jphacks/tka_2601/firmware/xiao/README.md

# MONBAN ファームウェア（XIAO ESP32S3）



E84 と M5Stack に分かれていた機能を、Seeed XIAO ESP32S3（無印）1 枚で動かすファームウェアです。追加基板（MAX98357A アンプ、LMD3526 PDM マイク）を前提にしています。基板の設計データはまだこのブランチにないので、ピン配置は下の表を見てください。

**実機ではまだ一度も動かしていません。** 確かめたことと確かめていないことは「[確認の状況](#確認の状況)」に書きました。

## 実機なしで試す

XIAO がなくても、次のコマンドで試せます。リポジトリのどこからでも `bash firmware/xiao/run.sh ...` で実行できます。

| コマンド | 確かめること | 必要なもの | 時間の目安 |
|---|---|---|---|
| `bash run.sh test` | 各部のホストテストと Web UI のテスト | clang、Python 3、Node.js | 1 分 |
| `bash run.sh e2e` | 本物の `/api/relay` のコードと、ファームウェアの通話処理をつないだ会話 | 上に加えて uv | 初回は依存の取得が要る |
| `bash run.sh browser` | 本物の Chromium で Web UI を開き、チャイム登録から通話まで実際にクリックして通す | e2e と同じ。初回は Chromium の取得（約 100 MB）が要る | 2 分 |
| `bash run.sh qemu` | ESP32-S3 用のバイナリを QEMU で起動し、シリアルで操作 | arduino-cli、Python 3 | 初回は ESP32 コアの取得（数 GB）が要る |
| `bash run.sh bench` | ブラウザで Web UI を操作する。通話まで動く | e2e と同じ | 起動まで数十秒 |
| `bash run.sh qemu ui` | ブラウザで Web UI を操作する。相手は QEMU 上の ESP32-S3 用バイナリ | qemu と同じ | 起動まで 1 分ほど |

Web UI を試す 2 つの違いは次のとおりです。`bench` は Mac 向けにコンパイルしたファームウェアで、音声は模擬なので通話まで進みます。`qemu ui` は実機用のバイナリそのものですが、QEMU に Wi-Fi と音声がないので、サーボの調整や保存までしか動きません。QEMU 自体に Web UI はなく、どちらも `http://127.0.0.1` の同じ画面を使います（`bench` は 8767 番、`qemu ui` は 8768 番）。

QEMU の本体は初回に公式リリースから `.host-build/` へ取得し、SHA-256 を照合します。対応するのは macOS と Linux です。Windows は WSL で動かしてください。

GitHub では、`firmware/xiao` に触れる PR ごとに `test`、`e2e`、`browser`、ビルド、`qemu` が自動で動きます。手で動かすときは Actions の「XIAO firmware」から Run workflow を押します。

## 機能

| 機能 | 内容 | 移植元 |
|---|---|---|
| チャイムの登録と検知 | ログメル特徴と DTW。環境音 5 秒、3 回の登録、別の 1 回の確認 | `firmware/psoc6` |
| 登録の保存 | 2 MiB の専用パーティションに 2 つ写しと CRC で保存 | `firmware/psoc6` |
| 録音の保存と送信 | HTTPS で WAV を送り、同じイベント ID の ACK を待つ。送信先を設定したときだけ動く | `firmware/psoc6` |
| 会話 | `/api/relay` と WSS で接続。16 kHz、16 bit、モノラルの PCM を 20 ms（640 B）ごとに送受信 | `PSOC_Edge_E84` |
| 再生 | I2S で再生し、DMA が空になってから完了を報告 | `M5Stack_Basic_E84_Link` |
| サーボ | 押して戻す動作、角度と時間の調整、USB からのテスト | `M5Stack_Basic_E84_Link` |
| 確認と調整の Web UI | Mac の `calibration_ui/` が USB シリアルで本体とやり取りする | `M5Stack_Basic_E84_Link` を作り直した |

E84 と M5 の間の UDP 通知と TCP 中継（DVS1）は削除しました。通話の処理が、サーボとスピーカーを直接動かします。

初期設定では物理プッシャー1が通話開始、2が終話です。アプリの「設定 → プッシャー設定」で、通話用に1個を共有するか、2個へ別々に割り当てるかを選べます。1個では物理1・2のどちらも選べ、2個では開始・終話の担当を入れ替えられます。接続数の自動検出は行いません。

物理3は解錠用のUSBテスト・角度調整として保持し、通話からは動かしません。中継サーバーに解錠の指示がなく、`docs/spec.md` 5.6 が「鍵やドアを開ける約束をしない」と決めているためです。

## ピン配置

`board_pins.h` に定義しています。

| XIAO | GPIO | つなぐ先 |
|---|---|---|
| D0 | 1 | アンプ DIN |
| D1 | 2 | アンプ LRCLK |
| D2 | 3 | アンプ BCLK |
| D3 | 4 | マイク DATA |
| D4 | 5 | マイク CLK |
| D5 | 6 | アンプ SD_MODE（Low で停止、駆動しないと (L+R)/2 のモノラル） |
| D8 | 7 | サーボ 1（通話） |
| D9 | 8 | サーボ 2（終了） |
| D10 | 9 | サーボ 3（解錠） |

## ビルドと書き込み

`arduino-cli` と esp32 コア 3.3.8 を使います。`arduino-cli` は PATH にあるものか Arduino IDE に入っているものを使い、コアがなければ初回に入れます。パーティションは `partitions.csv` のとおりで、PSRAM は OPI にしています。

```bash
bash run.sh build
```

```bash
bash run.sh upload /dev/cu.usbmodem1101
```

書き込みは XIAO 自身の USB-C から行います。追加基板の USB-C は電源専用で、書き込むときは抜いておきます。

## 設定

設定を変えたら、ビルドと書き込みをやり直します。作られるヘッダーは Git の対象外です。

Wi-Fi の設定です。iPhone のテザリングでは `--hotspot` を付けます。

```bash
python3 configure_wifi.py
```

サーバーの設定です。`.env.example` を `.env` にコピーして `DOOR_API_KEY`、`DOOR_RELAY_MODE`、`DOOR_DEVICE_KEY` を入れてから実行します。

```bash
python3 configure_api.py
```

録音の送信先は任意です。設定しない間は、録音をフラッシュに保存しません。`docs/spec.md` 5.2 と 10 章で扱いが未定のため、既定で切っています。

```bash
python3 configure_upload.py --ca /path/to/receiver-root-ca.pem
```

## 最初に動かす手順

### アプリからのプッシャー設定

アプリに保存した設定は、XIAOが待機中に取得し、本体への保存と読み戻しを確認してから反映結果を返します。通話中は割り当てを切り替えません。設定を保存しただけでは反映済みにならないため、本体への反映完了を確認してから取り付けを変更します。

本体の`.env`に`SUPABASE_URL`・`SUPABASE_PUBLISHABLE_KEY`と登録済みの`DOOR_DEVICE_KEY`を設定し、接続先の信頼するCAを指定します。

```sh
python3 configure_api.py
python3 configure_device.py --ca /path/to/trusted-root-ca.pem
bash run.sh build
```

生成した`device_config.h`はGit対象外です。設定APIの追加契約、XIAO、アプリの順に導入します。[実装・検証記録](../../docs/verification/pusher-assignment.md)に、エミュレーターで確認した範囲と未確認の実機動作を記載しています。

共有ボタンの押下中に中断・電源断が起きた場合や、共有する出力を単体テスト・プレビューした後は、親機を手動で終話してからUSB調整画面で待機状態を確認します。`@confirm`も同じ確認操作で、ボタンを押しません。再起動や割り当て変更だけでは要確認状態を解除しません。

### アプリからの動作モードと死活通信

アプリで選んだ動作モード（通常・おまかせ・外出・停止）は、待機中に15秒ごとに`GET /functions/v1/device/mode-settings`で取得します。ネットワークタスクが取得するため、チャイムの検知と通話は待たされません。通話中は取得しません。

- 取得した値は、通話中継への`mode`に使います。ビルド時の`DOOR_RELAY_MODE`は、一度も取得できていないときの初期値だけです。
- 最後に取得できた値をNVSに保存し、再起動後と通信できない間はその値で動きます。保存できなかったときも取得した値を使い、次の取得で保存を再試行します。
- 未対応の値、型や契約版が違う応答、HTTPエラー、未ペアの応答は、最後の正常値を変えません。不明な値を停止として扱うことはありません。
- 停止モードでは、チャイム検知と手動の通話要求を通話開始の前に捨てます。待たせて後から再生することはありません。通話中に切り替わっても、始まっている通話は止めません。通信確認用のAPI試験とスピーカー試験は停止モードでも使えます。
- `PUT /functions/v1/device/heartbeat`は、通信できる間60秒ごとに送ります。失敗したときは10秒から始めて60秒まで間隔を延ばして再試行し、成功した時刻だけを送信済みとして扱います。アプリの接続切れ通知は15分間heartbeatが途絶えたときです。

- `PUT /functions/v1/device/mode-status`（本文`{"mode":"normal"}`）で、本体が実際に動かしているモードをクラウドの`devices.applied_mode`へ報告します。アプリが保存した`devices.mode`とは別の値です。報告するのは、このブート中に`mode-settings`の取得が成功し、そのモードで動いているときだけです。NVSに保存された値やビルド時の`DOOR_RELAY_MODE`で動いている間は、取得が成功するまで報告しません（アプリの設定として動いているとは言えないため）。取得に成功した最初の1回は、モードが同じでも送ります。以後はモードが最後に報告に成功した値と変わったときだけ送ります。
  - 保存に失敗したモードも、実際に動いているので報告します。200以外と通信失敗は未送信として扱い、10秒から60秒までの上限つきの間隔で再試行します。新しいモードに変わったときは、古い失敗の間隔を引き継がず10秒から数え直します。取得・heartbeat・チャイムは報告の失敗に待たされません。
  - 未ペアの応答を受けたら報告済みの記録を捨て、ペアリング後に取得が成功した時点で改めて1回送ります。
  - `applied_mode_at`はクラウドが報告を受けた時刻で、本体の生存を示しません。本体との最後の通信は`last_heartbeat_at`です。
  - 実装は`device_mode_sync.c`、試験は`tests/device_mode_report_test.c`です。

同じ`device_config.h`の設定（`configure_device.py`）を使います。未設定の本体は、取得も送信もしません。

### 停止モードで応答しなかった来客の記録

停止モードでチャイム検知か手動の通話要求を捨てたとき、その来客を`PUT /functions/v1/device/visits/<uuid>`で記録します（`docs/spec.md` 5.1）。送る本文は`{"status":"missed","end_reason":"mode_off","mode":"off","chimed_at":"<UTC ISO 8601>"}`だけです。`chimed_at`は捨てた時点のNTP時刻です。`visit_report.c`が実装します。

- 時計が未同期（2024-01-01より前）のときは記録せず、ログに残します。偽の時刻は送りません。
- UUIDは本体が作ります。同じ来客の再送はサーバー側で1件のままです。
- 音声タスクは、メモリ上の4件のキューに積むだけで、通信を待ちません。送信はネットワークタスクが1回に1リクエストずつ、通話中以外に行います。
- キューが満杯のときは、新しい来客を捨てます（古い順に送り終えます）。20秒以内の続けてのチャイムは、通話後の待機と同じく1人の来客として数えます。
- 失敗は10秒から始めて60秒まで間隔を延ばし、1件につき最大6回送ります。それでも届かない件は捨てます。400番台（408、429を除く）は同じ本文では成功しないため、すぐ捨てます。
- キューは再起動で消えます。電源断をまたいで残す永続キューは、Issue #44の範囲で、未実装です。
- チャイム検知は、Wi-Fiと時計が使えない間は始まらないため、その間の停止モードのチャイムは記録されません。
- アプリの履歴一覧は`missed`を表示しません。この記録で届くのは、来客時のプッシュ通知までです。

ホストテスト（`bash run.sh test`の`visit_report`）とDBテストで確認した範囲です。実機のXIAOと実際のSupabaseでの動作は未確認です。

### 通話の順序と復旧

v2ではAPIのWSS接続と`ready`を確認してから通話ボタンを押し、ボタンが戻った後にエージェントを開始します。APIに接続できない場合は、ボタンを押さずにチャイム検知を再開します。従来のv1は通話ボタンを押した後に接続します。

通話ボタンの操作開始から50秒で通話を打ち切り、操作後20秒は新しい通話を受け付けません。終話を確認できなかった場合、開始と終了に別々のボタンを使う構成では、10秒、20秒、以後30秒の間隔で終了ボタンを再試行します。終了ボタンの操作が済み、録音の再開だけに失敗した場合は、サーボを動かさずに再開を試みます。

開始と終了に同じボタンを使う構成では、再押下による通話開始を避けるため自動で押し直しません。親機を手動で終話してからUSB調整画面、または`@confirm`で待機状態を確認します。プッシャー設定の適用待ちやサーボの要確認状態も、自動復旧では解除しません。

本体が確認するのはサーボの動作完了です。実際に親機が終話することや、押下中のサーバー接続が保たれることは、実機で未確認です。

### USB調整画面

`python3 calibration_ui/server.py --serial-port /dev/cu.usbmodem1101` を実行し、`http://127.0.0.1:8767` を開きます。あとは画面の順に進めます。

どの画面でも右側に 3D モデルが出ます。上のバーでインターホンの機種と外装を選びます。モデルは本体のログと設定値で動くので、サーボの押下、呼び出し、再生、聞き取りがそのまま見えます。その下に、部品がキーや画面、充電台に当たらないかを計算して出します。機種の外形は公開値で、キー位置は推定です。実測したら「寸法とキー位置を変える」に入れてください。機種は `calibration_ui/scene/monban_scene.js` の `INTERCOMS` に足すと増やせます。`rough` の付いた機種は、`coverage.md` の外形とキーの説明だけから配置を仮置きしています。縦に串を通す Windea-R と Windea D、キーの情報がない機種はまだ入っていません。外装は同じファイルの `DESIGNS` です。

| 画面 | できること |
|---|---|
| 仮想ボード | `bench` と `qemu ui` で出る。チャイムや違う音を鳴らし、通話を通しで試す。実機の接続先では出ない |
| テスト | `run.sh` の `test`、`e2e`、`build`、`qemu` を実行し、結果とログを見る |
| 動作確認 | 通信、マイク、スピーカー、サーボ、チャイム、通話を順に確かめる。音と動きは「聞こえた」「動いた」で答える |
| サーボ | 通話、終了、解錠の角度と時間を合わせて本体に保存する。ホーンを外した状態で始める |
| 音 | マイクの音量を見ながら話し始めの音量を決める。スピーカーの音量とチャイムの判定幅を変える |
| チャイム | 案内に従って登録する。保存領域が未初期化なら、そのときだけ初期化のボタンが出る |
| テスト通話 | 通話を始める、止める。進行状況、会話、本体のログを見る |

実機がなくても、この画面を次のコマンドで動かせます。本物のファームウェアのコードと中継のコードを Mac 上で動かします。マイク、スピーカー、PWM は模擬で、音声 AI は決まった応答に置き換えています。チャイムは画面のボタンで鳴らします。

```bash
bash run.sh bench
```

## シリアルのコマンド

1 行に 1 つ送ります。

| 入力 | 動作 |
|---|---|
| `h` | 一覧 |
| `s` | 状態 |
| `c` / `q` | 通話を始める / 止める |
| `e` / `x` | チャイム登録を始める / 登録とサーボのテストを止める |
| `r` | 5 秒録音して送信待ちにする（送信先の設定が必要） |
| `1` `2` `3` | サーボのテスト（通話、終了、解錠） |
| `t` | スピーカーで 1 kHz を 1 秒鳴らす |
| `l` | 3 秒録音してそのまま再生する。保存はしない |
| `m` | マイクの音量と検知の状態 |
| `n` `a` `w` `u` | Wi-Fi、サーバーの HTTPS、音声の WSS、USB の確認 |
| `@get` `@begin` `@set` `@angles` `@time` `@test` `@stop` `@mirror e` `@save` `@cancel` | サーボの調整。M5 と同じ形で、`u`（解錠）を足した |
| `@tune get`、`@tune volume 0..100`、`@tune gate 30..32767`、`@tune margin 50..200` | 音量、話し始めの音量、チャイムの判定幅。すぐに NVS へ保存する |
| `FORMAT_AUDIO_STORAGE` | 保存領域を消去して初期化する。Web UI からは未初期化のときだけ送れる |

## テスト

```bash
bash run.sh test
```

移植元のホストテストに相当するものです。C と C++ は AddressSanitizer と UndefinedBehaviorSanitizer を付けて動かします。

```bash
bash run.sh e2e
```

`backend/voice-agent` の本物の `/api/relay` v2 のコードに、このファームウェアの通話処理をそのままつなぐテストです。通常の会話、チャイムから始まる通話、途中で止めた通話、サーバーに届かないとき、API キーを拒否されたときを確かめます。置き換えているのは次の部分だけです。

- 音声認識、応答生成、音声合成
- TLS（平文の TCP でつなぐ）
- マイク、スピーカー、PWM、NVS、フラッシュ

```bash
bash run.sh qemu
```

ESP32-S3 用にビルドしたバイナリを、Espressif の QEMU で起動してシリアルで操作するテストです。実機向けのビルドとの違いは、QEMU に合わせた次の 3 点だけです。

- 出力先が USB CDC ではなく UART
- フラッシュが QIO ではなく DIO
- USB 専用のタイムアウト設定 1 行を除く

QEMU には Wi-Fi と I2S のデータがないため、ネットワークと音はこのテストでは確かめられません。

## 確認の状況

### 確かめたこと

- `esp32:esp32:XIAO_ESP32S3` 向けのビルド（プログラム 32%、静的 RAM 61%）
- `bash run.sh test`：すべて成功。動作モードの追従（厳密な解析、最後の正常値の保持と再起動後の復元、停止モードでの通話の遮断、取得とheartbeatの間隔、適用モードの報告の条件・再試行・重複なし）は、模擬のHTTPとNVSで確かめた
- `bash run.sh e2e`：5 件すべて成功（動作モードの追加後も実施）
- `bash run.sh qemu`：すべて成功。確かめたのは次の項目です。
  - 実バイナリの起動、PSRAM、パーティション、全タスクの起動
  - PDM、I2S、LEDC の各ドライバーが設定を受け付けること
  - 3 つのサーボの動作と、シリアルのコマンド
  - NVS への保存と 2 MiB の領域の初期化、電源を入れ直した後の復元
  - ネットワークやマイクがないときに固まらず失敗を報告すること
- `bash run.sh browser`：Chromium（Playwright）で、全画面の表示と 3D の描画、機種と外装の切り替え、実測値の入力、接続とスピーカーとサーボの確認、チャイム登録、チャイムからの通話、通話の停止、テストの実行と停止、狭い画面幅を確かめ、コンソールにエラーがないことを確認
- `bash run.sh bench` とブラウザで、Web UI の主な操作（機種と外装の切り替え、まとめて確認、サーボのテスト、チャイム登録、チャイムからの通話とその間の 3D の動き、違う音の判定、テストの実行）

### 実機で確かめていないこと

下の項目は、どれも動作を確認していません。

| 項目 | 確かめること |
|---|---|
| 起動 | QIO フラッシュと USB シリアルでの起動（QEMU は DIO と UART で確認） |
| Wi-Fi と時刻 | 接続、再接続、NTP の同期、テザリングでの接続 |
| TLS と WSS | 実サーバーとの証明書の検証、有効期限の確認、接続中のメモリの余裕 |
| マイク | LMD3526 から正しい音が取れるか。特に左チャンネルの指定と 2.048 MHz のクロック |
| アンプ | MAX98357A が鳴るか、SD_MODE の切り替え、切り替え時の雑音、音量 70% が適切か |
| サーボ | FS0307 が 1000〜2000 µs で必要な角度に動くか（M5 で使った SG90 の値のまま）。14 bit の PWM の精度。押す角度の既定 30 でキーが押せるか。30 は 167 µs ぶんで、実際の回転角は測っていない。サーボ画面のラックの mm は、指定どおりの角度で回った場合の計算 |
| サーボの向き | 既定では通話と終了のパルスが逆向きに動く。機構に対して正しいか |
| 電源 | サーボが動くときと大きな音のときに電圧が下がらないか |
| 同時動作 | Wi-Fi、TLS、マイク、再生を同時に動かしたときに音が途切れないか |
| フラッシュ | 消去中にマイクの取り込みが途切れないか（1 セクターごとに消去している） |
| チャイム | 実際の呼び出し音での取り逃しと誤検知。しきい値は初期値のまま |
| 話し始めの判定 | `VOICE_RMS_GATE` の 600 は E84 のマイクの値で、このマイクでは測っていない |
| 回り込み | スピーカーとマイクが同じ外装に入ったときの影響 |
| 通話全体 | 実際のインターホンと実サーバーでの連続した会話 |
| 動作モードとheartbeat | 実サーバーでのモード取得、停止モードで実際のチャイムに応答しないこと、再起動後と通信断のときに最後の正常値で動くこと、heartbeatがアプリの接続切れ通知と一致すること。適用モードの報告も、ホストテストの模擬サーバーだけで、実サーバーの`devices.applied_mode`への反映は未確認。ホストテストは模擬のHTTPとNVSで確かめただけ |
| 録音の送信 | 実際の受信サーバーへの送信 |
| v1 の中継 | `VOICE_RELAY_PROTOCOL=1` は C のテストだけで、LiveKit とはつないでいない |

## 移植元から変えたこと

- サーボの PWM は 16 bit から 14 bit にしました。ESP32-S3 の LEDC は 14 bit までです。
- 再生後に録音を始めるまでの待ちは 250 ms から 500 ms にしました。`docs/spec.md` 5.1 の値です。
- mbedTLS のこのビルドは証明書の有効期限を見ないため、接続後に NTP の時刻と照合しています。
- 音量の既定は 70% です。5 V のアンプはフルスケールで 1 W のスピーカーの定格を超えるおそれがあるためです。
- チャイムを検知したら、録音の残りを待たずに通話を始めます。録音の保存は通話が終わってから行います。フラッシュの処理で通話の音が途切れないようにするためです。

## 未実装

E84 と M5 にもなく、`docs/spec.md` だけにある機能は移していません。

- 定型音声 U01、X01（5.7）
- 本体から Supabase の Edge Function への送信（5.5）
- 通話後 20 秒のチャイム検知の停止（5.1）
- 停止モードで応答しなかった来客の記録は、メモリ上のキューまで実装済みです（上の節）。再起動をまたぐ永続化は未実装です（Issue #44）
- 適用モードの報告（`PUT /mode-status`）は、実機と実サーバーではまだ確かめていない（上の節）。取得した時刻の報告は未実装で、通信の生存は heartbeat だけが伝える

押す時間の上限は M5 と同じ 2000 ms です。`docs/spec.md` 4.4 は 500 ms を上限としているので、VS-MGE20 で使うときは 500 ms 以下に合わせてください。
