jphacks/tka_2601/PSOC_Edge_E84/docs/voice-stream.md

# E84・M5の音声会話

## 実装した流れ

チャイム検知、またはE84のUARTで `c` → APIへWSS接続して `ready` を確認 → M5の接続確認 → 設定した時間だけ待つ → 通話ボタンを1回押す → 待機位置へ戻してPWM停止 → agent開始 → 挨拶 → 来訪者の音声 → ASR/LLM/TTS → M5再生 → 次の録音、を繰り返します。会話終了時は最後の音声の再生後に終了ボタン用サーボを動かします。`q` は録音・再生を止めて通話終了を要求します。APIに届かないときは、M5へ接続せず通話ボタンも押しません。この先行接続はv2の順序です。v1は従来どおりボタン操作の後にAPIへ接続します。

E84がWi-Fi/API認証と会話状態を管理します。CM55はPDM取得・チャイム照合・発話区切り、CM33はWSSとM5へのTCP転送を担当します。クラウドへは既存の `/api/relay` にJSON制御と生PCMを送り、M5へは従来のDVS1を送ります。サーバーのv2経路は既存DoorAgentを同じLiveKit Agents SDKのAgentSession内で動かします。音声認識は発話確定後に既存STTクライアントで実行し、応答生成・TTS・住人ルールを再利用します。ブラウザーと旧relayのLiveKitルーム経路は維持します。

音声は16kHz/16bit/mono。20ms（640バイト）単位で送信し、発声後の無音1.2秒または30秒で区切ります。30秒には200msの先行バッファと末尾無音も含みます。無音だけなら音声フレームを送信せず待ちます。最初の発話待ちは60秒です。サーバーの通話上限は既存の `DOOR_RELAY_MAX_SESSION_SECONDS`（既定120秒）に従います。端末にも切断時の上限がありますが、サーバーの期限を延長するものではありません。

発声判定はRMSを使います。`source/voice_settings.h` の `VOICE_RMS_GATE`（既定600）以上が60ms続くと開始し、その半分未満の音量が1.2秒続くと終了します。学習済みVADではないため、設置場所の雑音・マイク音量で調整してください。録音と返答の同時進行・割り込み発話には対応しません。

CM55→CM33は64フレーム、1.28秒分の共有リングです。共有領域の使用量は約233KBで256KiB以内です。30秒分全体をE84に保持しません。サーバーはASRのため1発話を最大960KBまで保持します。応答待ち・再生中のマイクサンプルは捨て、次の録音に混ぜません。

## サーバーへ反映

既定は `VOICE_RELAY_PROTOCOL=2` です。2026-10-18に稼働中サーバーから `ready` / `protocol_version:2` を確認し、非個人の合成音声で発話送信→ASR→返答PCM→次の聞き取りまで成功しました。E84の無音判定で発話を確定し、`input_end` のフレーム数・サンプル数をサーバーが検証した後にASRへ渡します。サーバーの別のVADによる再判定はありません。M5の実再生完了後に `playback_done` を送り、明示的な `listen` が届いてから次の録音を始めます。

稼働中サーバーのv2は現時点では `transcript` を端末へ転送しません。Web UIの会話テキストを表示するには、[サーバー用の追加パッチ](../../deliverables/relay-v2-log-update-20261018/README.md) をAPIプロセスへ適用します。このMacからはサーバーへ未適用です。音声の送受信とは別の追加修正です。

旧サーバーを使う場合は `VOICE_RELAY_PROTOCOL=1` に戻します。v2はバージョンなしreadyを拒否し、暗黙にv1へ切り替えません。`POST /api/connect` はブラウザーのLiveKit用で、E84の接続先には使いません。OpenAPIにはWebSocketは表示されません。

旧v1経路では `agent_state: listening` の後も低い非ゼロPCMが続くことを確認しています。v1接続ではこの状態通知から500msの末尾音声を受けた後にM5へ `OUTPUT_END` を送り、それ以後の待機PCMを捨てます。単なるPCMの途切れだけでは終了しません。M5から実再生完了が戻り、250msの残響待ちを終えてから次の録音を許可します。LiveKitのVADがE84の無音1.2秒より先に返答を始めた場合も、録音を止めて再生へ切り替え、残った入力を次の発話に混ぜません。AIの確定文字起こしに「失礼いたします」が含まれる場合、最後の再生後に終了操作を行います。手動終了はUART `q` です。 ローカルRMSが拾った音をサーバー側VADが認識しない場合に備え、入力終了後もagentが聞き取り状態のまま20秒経過するとマイクを再待機します。`thinking` や再生中には再待機せず、遅れて返答が始まった場合も直ちに録音を止めます。認識内容・agent状態・既知のエラーコードはUSB/Web UIへ表示します。

v2の通話では発話単位の制御、フレームACK、`output_end` / `listen` / `call_end` を使います。終了時は `Call ending: reason=...`、サーバー通知時は既知の `Server error code` / `Server end reason` を表示し、正常終了・時間上限・切断・音声送信失敗を区別します。サーバーの時間上限を端末側で延長することはありません。

E84の `.env` にAPI設定に加えて `DOOR_RELAY_MODE=omakase` と `DOOR_DEVICE_KEY` を設定します。デバイス鍵はSupabaseの住人設定取得・履歴保存用で、FastAPI認証の `DOOR_API_KEY` とは別です。両バージョンとも鍵が空なら、バックエンド付属シミュレーターと同様に未登録の診断用IDで通話できます。この場合、住人設定の取得と履歴保存はできません。未登録状態は本体ログに明示します。APIへのBearer認証は引き続き必須です。キーを設定した後、設定生成とビルドを行います。M5との通信は設定済みUDPポート+1（標準8769/TCP）と、同じペアリングトークンを使います。

## 書き込み

M5を先に更新します。USBポートは現在の接続に合わせて指定してください。

```sh
cd /Users/fukawanozomi/Documents/ChatGPT/jphacks/M5Stack_Basic_E84_Link
bash run.sh build
bash run.sh upload /dev/cu.usbserial-58650035241
```

続いてE84を更新します。

```sh
cd /Users/fukawanozomi/Documents/ChatGPT/jphacks/PSOC_Edge_E84
python3 configure_api.py
make -j8 build
make -j8 program
```

M5のIPが変わった場合は、既存の `python3 configure_m5.py --host <M5のIP>` で更新します。両方を同じiPhoneテザリングまたはLANへ接続してください。

## サーボのサンプル

通話用GPIO26、終了用GPIO17の2台構成です。標準の通話動作は3秒待機→押下位置を0.3秒保持→待機位置へ1秒戻してPWM停止です。角度・通話前待機・通話と終了の押下時間・復帰時間はWeb UIで保存できます。旧版の保存済み角度は引き継ぎます。通話ボタンの操作完了通知を受け取るまで、E84はagent開始のJSON（`call_started`）を送りません。v2ではWSS接続と `ready` の確認はその前に済ませ、ボタン操作中も5秒ごとのPINGで接続を保ちます。v1ではWSS接続自体をボタン操作の後に行います。実サーボ用の電源と共通GND、角度調整は[M5 README](../../M5Stack_Basic_E84_Link/README.md)を参照してください。センサーはなく、完了通知はPWM操作の完了を意味します。

未配線でもサンプルPWMコードは動作します。ボタンを人が押して連携を確認する場合は、M5の `servo_config.h` で `M5_SERVO_ENABLED 0`、`M5_SERVO_MANUAL_TEST 1` を明示します。開始はM5のA、終了はCで操作完了を通知します。

## 順に確認すること

1. E84の `t` で従来のUDP往復を確認します。
2. E84の `c` でチャイム検知を省略して通話を開始します。通話用サーボが動くので、取り付け前に角度を確認してください。
3. M5から挨拶が流れ、E84が `M5 playback complete` → `Listening` と表示することを確認します。
4. 話した後に1.2秒黙り、`Input complete` → M5の返答 → 次の `Listening` になることを確認します。
5. 長い発話を30秒で区切ること、返答再生中に録音が開始しないことを確認します。
6. `q` または会話の終了で終了ボタン用サーボが動くことを確認します。
7. 最後に実際のチャイムから開始します。通話中は再検知を抑制します。

切断・PCM欠落・バッファあふれでは不完全な発話を取り消します。M5は音声を停止し、通話押下済みなら終了ボタンを一度押します。E84がM5の終了を確認できない場合は録音を止めたままにし、M5へ自動で再接続します。再接続は10秒、20秒、30秒の間隔で行い、30秒が上限です。M5が `CALL_ENDED` を返したら、チャイム検知を再開します。待機中の本体ログは、初回と60秒ごとにだけ出ます。再接続で送るのは `HELLO` と `CANCEL` だけで、通話開始やボタン操作は行いません。M5が応答しない間は新しい通話を始めません。M5の状態が不明のままなら、インターフォンの状態を確認してM5を再起動してください。

SDKのTCP接続確立処理は同期呼び出しで、接続先が応答しない場合はSDKの接続タイムアウトまで待つことがあります。この間は録音を停止します。v2ではAPIへ接続して `ready` を確認した後に、M5の接続を確認してボタンを操作します。APIに届かなければボタンは押さず、録音を再開します。ボタン操作中にAPIとの接続が切れた場合は、M5へ終了操作を要求します。v1では従来どおりM5のボタン操作の後にAPIへ接続し、接続に失敗するとM5へ終了操作を要求します。シリアルの `q` は接続呼び出しが戻った時点で処理します。

## 検証範囲

ホストテストでは30秒・1.2秒境界、録音停止、欠落、再生完了の条件、JSON/PCMとDVS1の変換、WebSocket分割、通信切断、サーボ重複抑止を検証します。v1については待機中PCM、発話状態後の末尾音声、M5再生完了待ち、先に返答を始めるサーバーVAD、20msの無音送信も確認します。実機ではE84から実サーバーへの接続とM5での挨拶再生、ch3のマイク入力を確認済みです。位置合わせ後の実機連続通話は別途確認が必要です。

Macから実サーバーのASR・LLM・TTSだけを一往復させる診断もできます。`websocket-client` と `certifi` のあるPythonで、16kHz・16bit・monoの訪問者WAVを渡します。

```sh
python3 tools/relay_smoke_test.py visitor.wav --seconds 60
```

認証はこのE84プロジェクトの `source/api_config.h` を読み、登録住人に紐付かない診断用IDで既存 `/api/relay` へ接続します。サーボ・E84のマイク・M5のスピーカーを経由するテストではありません。空のWAV・全ゼロ音声・30秒を超える音声を拒否し、来訪者の文字起こし・AI文字起こし・返答PCMのすべてが確認できた場合だけ終了コード0になります。2026-10-18に「こんにちは。宅配便です。荷物をお届けに来ました。」から「恐れ入りますが、玄関の前に置いていただけますか。」の返答PCMまで成功しました。

最新TTSは不要な末尾音を除くため返答全体の生成を待ってから音声を流します。今回の更新はこの処理を変更しません。音声の転送・M5での再生はフレーム単位ですが、生成途中からの低遅延再生を保証するものではありません。

実機を動かさないv2の診断（送信してよい音声のみ）:

```sh
python3 tools/relay_v2_smoke_test.py diagnostic.wav --seconds 90
```

640バイトのPCM、発話終了、全フレームのACK、再生完了、次の聞き取りまでを確認します。登録住人の鍵を使わず、サーボは動かしません。実機のマイクの音質や取り付け位置は別に確認してください。

UART `v` またはWeb UIの「音声用TCPを確認」で、M5へのHELLO/READY認証とPING/PONGを診断できます。`CALL_START` / `CALL_END` / `CANCEL` は送信せず、サーボ・マイク・agentを起動しません。調整中のM5はTCP接続を拒否するので、角度を保存または取消してから実施します。`t` は別のUDP疎通診断です。

送信バッファの一時的な満杯（Secure Sockets `WOULDBLOCK`、`0x082a001a`）は切断とみなさず、最大2秒の範囲で未送信部分を再試行します。部分送信済みのバイトは再送しません。Secure Sockets 3.12.2のTCP送信はlwIPへNOCOPYで渡すため、CM33_NSのリンク時に `netconn_write_partly` を `socket_copy.c` でラップし、`NETCONN_COPY` を付けます。取得済みのSDKソースは変更せず、一時的な音声・TLS送信バッファを再利用しても未送信データが上書きされないようにしています。

異常終了でM5の停止を確認できない場合、復旧待ちフラグで新規通話と録音を抑止します。フラグはM5が停止を確認するまで解除されず、上記の自動再接続が解除を試みます。ネットワーク処理のbusyとは分離しているため、UDP/TCP/HTTPS/WSSの診断を実行できます。M5が応答しないままなら、実機を確認してM5を再起動します。音声中継は1msの受信待ちと最大4パケットのまとめ読みで、M5の応答とマイク入力を継続して処理します。
