jphacks/tka_2601/firmware/wifi-check/images/figure2.png

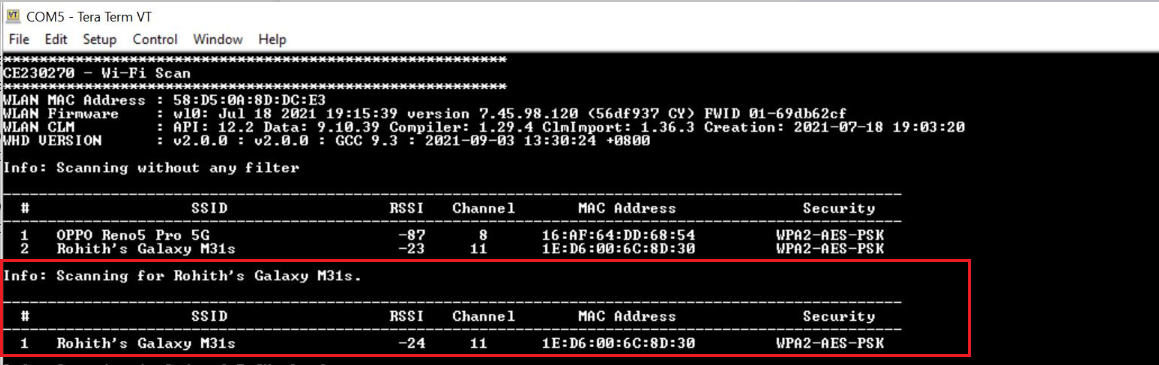
firmware/wifi-check/images/figure2.png
