jphacks/tka_2601/firmware/wifi-check/images/figure3.png

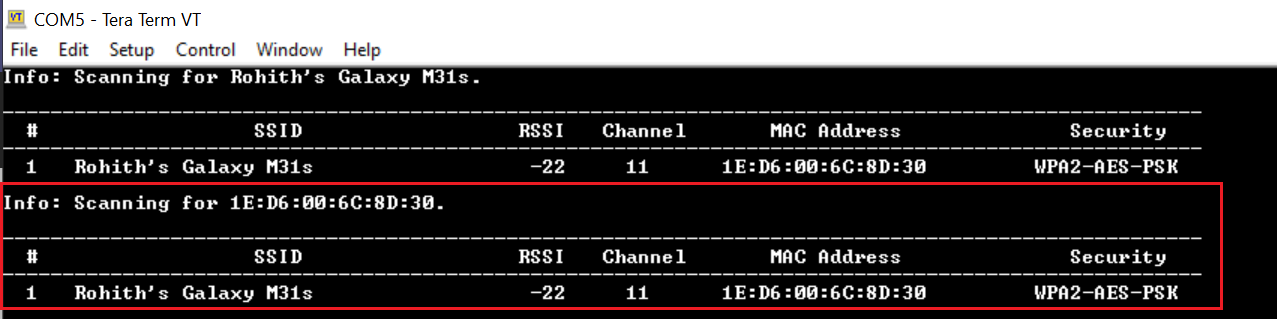
firmware/wifi-check/images/figure3.png
