jphacks/tka_2601/hardware/vsmge20_print_ready/layout.csv

plate | part | x_mm | y_mm | rotate_xy_90 | footprint_x_mm | footprint_y_mm | height_mm
2 | PRINT_01_Front_guard.stl | 5.00 | 5.00 | False | 127.00 | 84.00 | 7.60
2 | PRINT_02_Upper_bridge.stl | 5.00 | 92.00 | False | 108.00 | 20.00 | 14.50
2 | PRINT_03_Lower_bridge.stl | 5.00 | 115.00 | False | 108.00 | 20.00 | 14.50
2 | PRINT_04_Call_servo_pod_base.stl | 135.00 | 5.00 | True | 50.00 | 25.00 | 3.00
2 | PRINT_05_End_servo_pod_base.stl | 5.00 | 138.00 | False | 50.00 | 25.00 | 3.00
2 | PRINT_06_Call_pod_retainer.stl | 116.00 | 92.00 | False | 42.90 | 19.70 | 4.80
2 | PRINT_07_End_pod_retainer.stl | 116.00 | 115.00 | False | 42.90 | 19.70 | 4.80
1 | PRINT_08_Charger_cradle_frame.stl | 5.00 | 5.00 | False | 152.00 | 108.00 | 48.00
3 | PRINT_09_Call_pusher_shaft.stl | 16.40 | 5.00 | False | 7.00 | 7.00 | 1.90
2 | PRINT_10_Call_stop_collar.stl | 126.20 | 138.00 | False | 17.00 | 17.00 | 1.20
2 | PRINT_11_Call_guide_ring.stl | 146.20 | 138.00 | False | 14.00 | 14.00 | 1.60
3 | PRINT_12_End_pusher_shaft.stl | 45.20 | 5.00 | False | 5.60 | 5.60 | 1.90
2 | PRINT_13_End_stop_collar.stl | 163.00 | 5.00 | False | 10.60 | 10.60 | 1.20
3 | PRINT_14_End_guide_ring.stl | 5.00 | 5.00 | False | 8.40 | 8.40 | 1.60
3 | PRINT_15_Call_servo_horn.stl | 26.40 | 5.00 | False | 6.40 | 6.40 | 3.00
3 | PRINT_16_End_servo_horn.stl | 35.80 | 5.00 | False | 6.40 | 6.40 | 3.00
2 | PRINT_17_Call_servo_arm_HOME.stl | 58.00 | 138.00 | False | 31.10 | 20.83 | 2.00
2 | PRINT_18_End_servo_arm_HOME.stl | 92.10 | 138.00 | False | 31.10 | 20.83 | 2.00
2 | PRINT_19_Call_fork_cheek_A.stl | 161.90 | 92.00 | False | 10.00 | 3.20 | 1.00
2 | PRINT_20_Call_fork_cheek_B.stl | 161.90 | 115.00 | False | 10.00 | 3.20 | 1.00
2 | PRINT_21_End_fork_cheek_A.stl | 163.19 | 138.00 | False | 10.00 | 3.20 | 1.00
2 | PRINT_22_End_fork_cheek_B.stl | 5.00 | 166.00 | False | 10.00 | 3.20 | 1.00
3 | PRINT_23_Call_follower_pin.stl | 53.80 | 5.00 | False | 3.00 | 3.00 | 2.00
3 | PRINT_24_End_follower_pin.stl | 59.80 | 5.00 | False | 3.00 | 3.00 | 2.00
4 | TPU_01_Call_button_pad.stl | 5 | 5 | False | 6.999217987060547 | 6.998434066772461 | 0.800000011920929
4 | TPU_02_End_button_pad.stl | 16.999217987060547 | 5 | False | 5.599998474121094 | 5.596870422363281 | 0.800000011920929
