jphacks/tka_2601/hardware/vsmge20_print_ready/FRIEND_PRINT_PACKAGE/Plate_02_main_PLA_square20.3mf

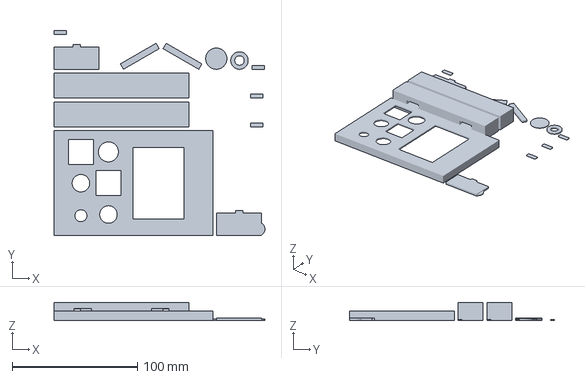
[picture p4: CAD file, 2026-10-17]
hardware/vsmge20_print_ready/FRIEND_PRINT_PACKAGE/Plate_02_main_PLA_square20.3mf
168.6 x 164.2 x 14.5 mm
