jphacks/tka_2601/hardware/vsmge20_print_ready/PLA_parts/PRINT_11_Call_guide_ring.stl

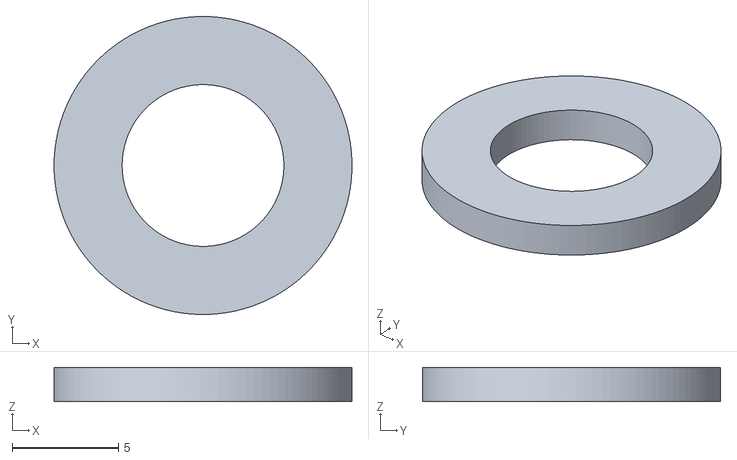
[picture p5: CAD file, 2026-10-17]
hardware/vsmge20_print_ready/PLA_parts/PRINT_11_Call_guide_ring.stl
14.0 x 14.0 x 1.60
