jphacks/tka_2601/hardware/vsmge20_print_ready/VS-MGE20_E84_M5StackBasic_A1mini_0p12_PLA.3mf

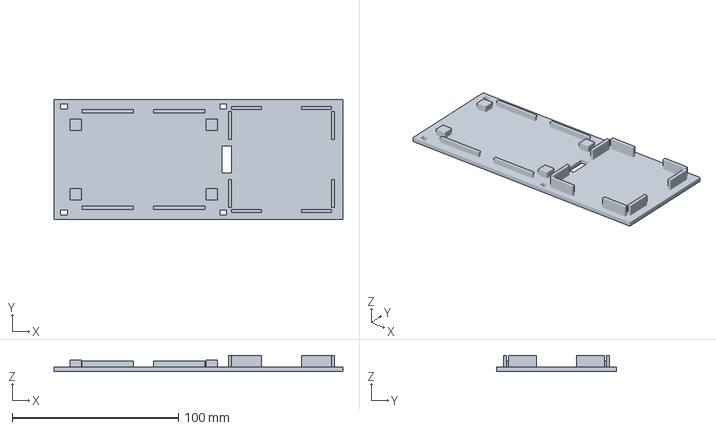
[picture p6: CAD file, 2026-10-17]
hardware/vsmge20_print_ready/VS-MGE20_E84_M5StackBasic_A1mini_0p12_PLA.3mf
174.0 x 72.0 x 9.80 mm
