jphacks/tka_2601/hardware/vsmge20_print_ready/PLA_parts/PRINT_24_End_follower_pin.stl

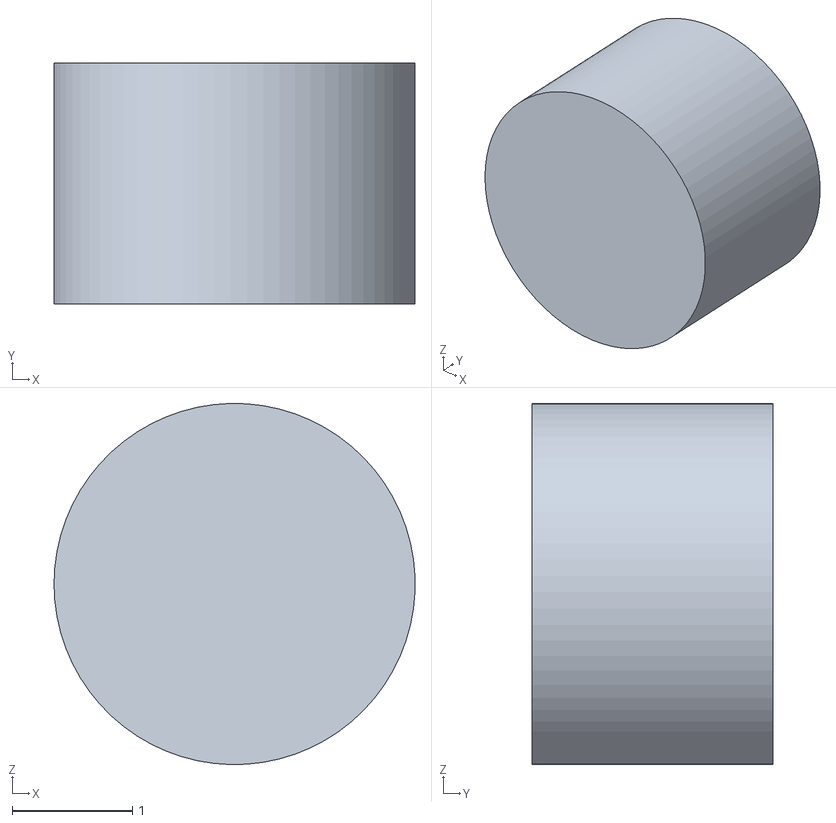
[picture p7: CAD file, 2026-10-17]
hardware/vsmge20_print_ready/PLA_parts/PRINT_24_End_follower_pin.stl
3.00 x 2.00 x 3.00
