jphacks/tka_2601/hardware/vsmge20_print_ready/Plate_02.stl

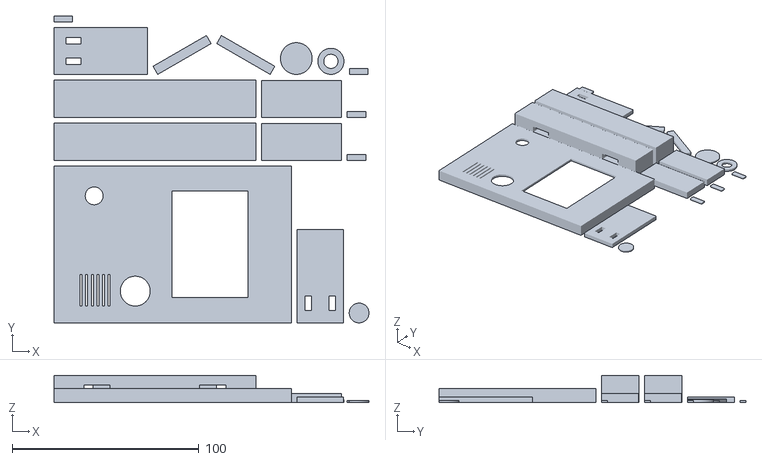
[picture p8: CAD file, 2026-10-17]
hardware/vsmge20_print_ready/Plate_02.stl
168.6 x 164.2 x 14.5
