jphacks/tka_2601/hardware/vsmge20_print_ready/PLA_parts/PRINT_04_Call_servo_pod_base.stl

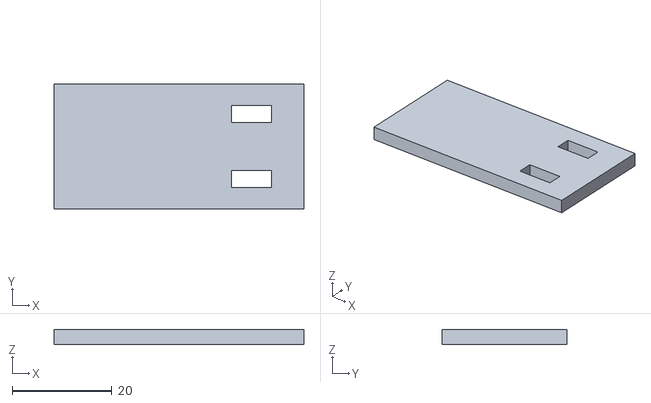
[picture p9: CAD file, 2026-10-17]
hardware/vsmge20_print_ready/PLA_parts/PRINT_04_Call_servo_pod_base.stl
50.0 x 25.0 x 3.00
