jphacks/tka_2601/hardware/vsmge20_print_ready/VS-MGE20_SG90_Plate03.3mf

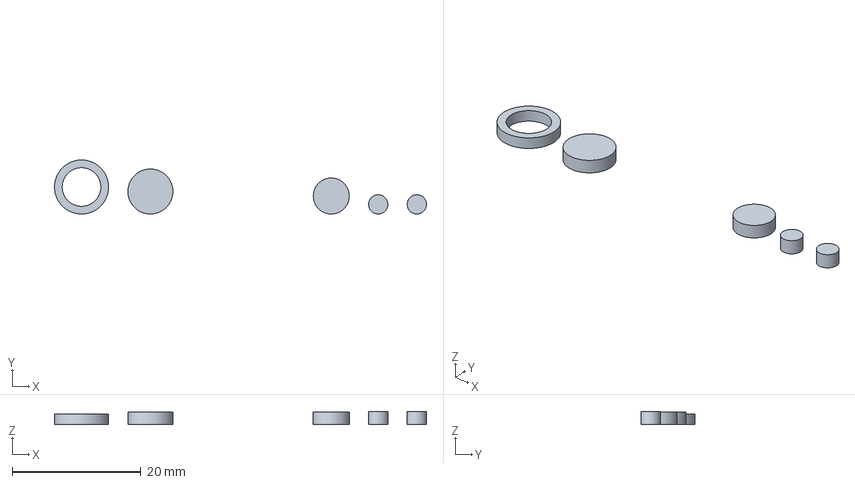
[picture p10: CAD file, 2026-10-17]
hardware/vsmge20_print_ready/VS-MGE20_SG90_Plate03.3mf
57.8 x 8.40 x 2.00 mm
