jphacks/tka_2601/hardware/vsmge20_print_ready/PLA_parts/PRINT_02_Upper_bridge.stl

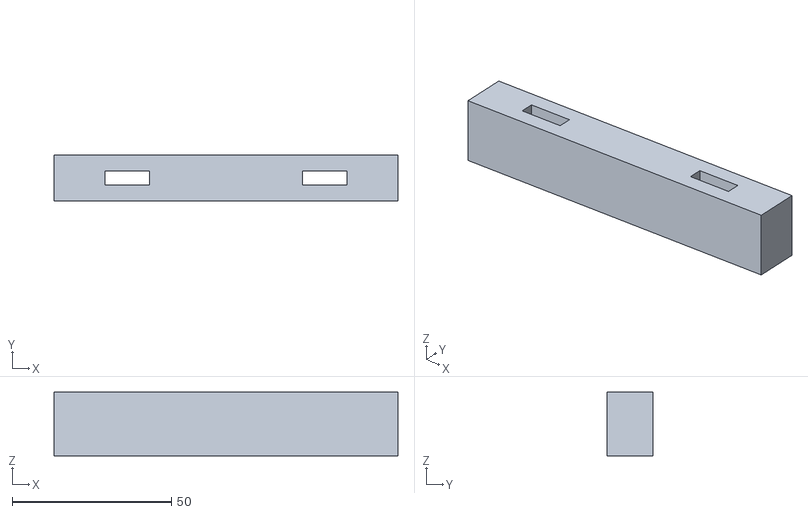
[picture p11: CAD file, 2026-10-17]
hardware/vsmge20_print_ready/PLA_parts/PRINT_02_Upper_bridge.stl
108.0 x 14.5 x 20.0
