jphacks/tka_2601/hardware/vsmge20_print_ready/PLA_parts/PRINT_13_End_stop_collar.stl

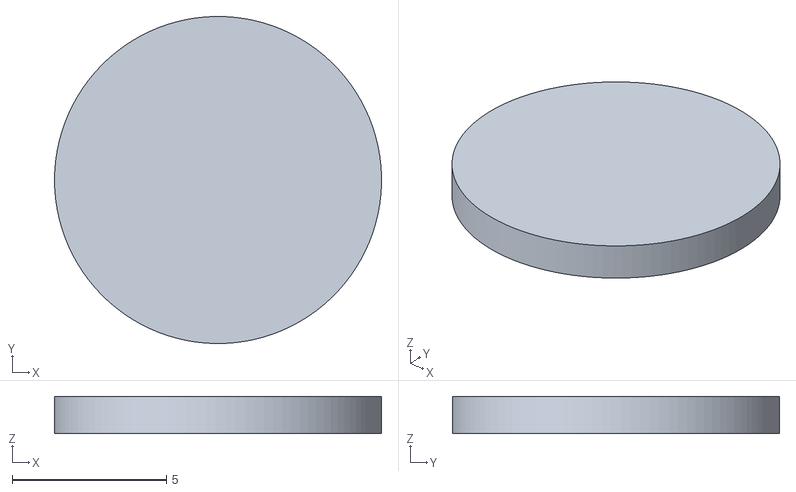
[picture p12: CAD file, 2026-10-17]
hardware/vsmge20_print_ready/PLA_parts/PRINT_13_End_stop_collar.stl
10.6 x 10.6 x 1.20
