jphacks/tka_2601/hardware/vsmge20_print_ready/PLA_parts/PRINT_21_End_fork_cheek_A.stl

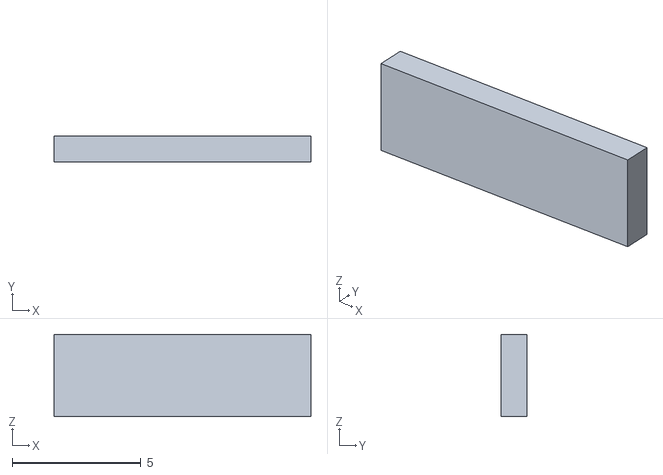
[picture p13: CAD file, 2026-10-17]
hardware/vsmge20_print_ready/PLA_parts/PRINT_21_End_fork_cheek_A.stl
10.0 x 1.00 x 3.20
