jphacks/tka_2601/hardware/vsmge20_print_ready/PLA_parts/SG90_mount_End.stl

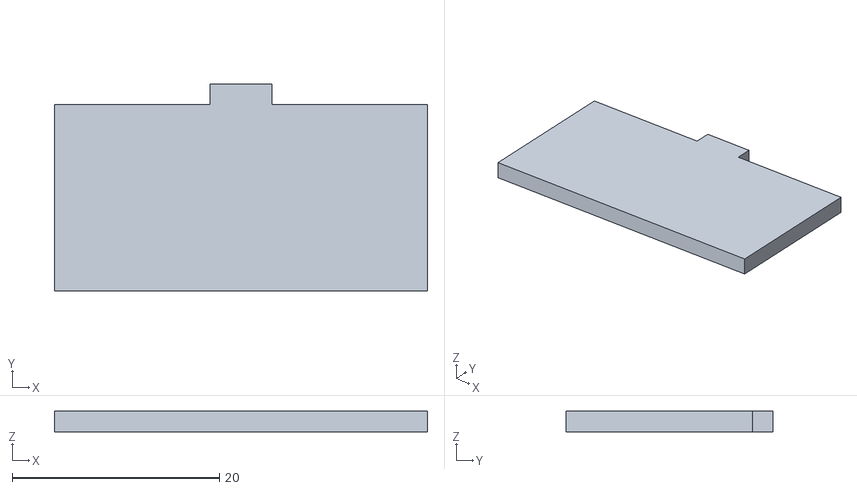
[picture p14: CAD file, 2026-10-17]
hardware/vsmge20_print_ready/PLA_parts/SG90_mount_End.stl
36.0 x 20.0 x 2.00
