jphacks/tka_2601/hardware/vsmge20_print_ready/PLA_parts/PRINT_01_Front_guard.stl

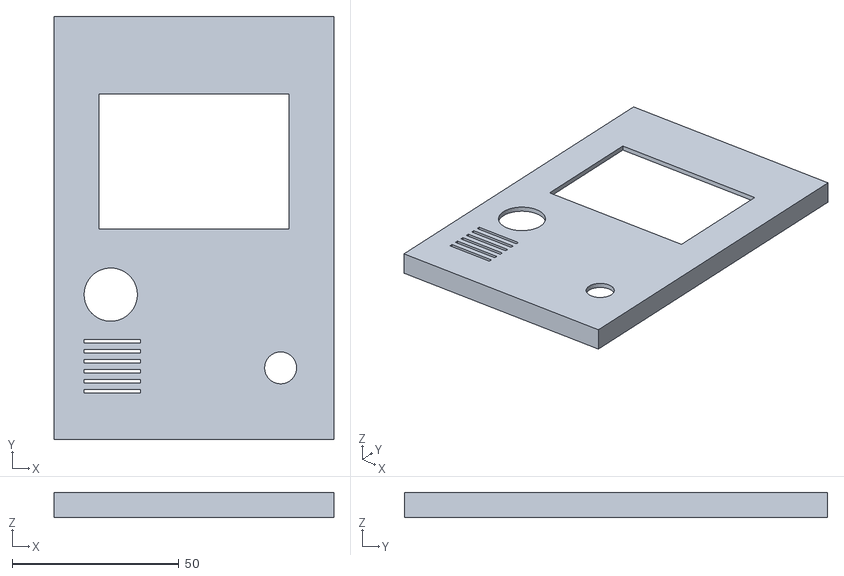
[picture p15: CAD file, 2026-10-17]
hardware/vsmge20_print_ready/PLA_parts/PRINT_01_Front_guard.stl
84.0 x 127.0 x 7.60
