jphacks/tka_2601/(list of files, cad)

Other CAD files:
hardware/vsmge20_print_ready/VS-MGE20_Case_SG90_square20.f3d
