jphacks/tka_2601/PSOC_Edge_E84/bsps/TARGET_APP_KIT_PSE84_AI/cy_device_headers_s.h

/***************************************************************************//**
* PSE846GPS2DBZC4A device header with secure MMIO offsets
*
********************************************************************************
* \copyright
* (c) 2016-2026, Infineon Technologies AG or an affiliate of
* Infineon Technologies AG.
* SPDX-License-Identifier: Apache-2.0
*
* Licensed under the Apache License, Version 2.0 (the "License");
* you may not use this file except in compliance with the License.
* You may obtain a copy of the License at
*
*     http://www.apache.org/licenses/LICENSE-2.0
*
* Unless required by applicable law or agreed to in writing, software
* distributed under the License is distributed on an "AS IS" BASIS,
* WITHOUT WARRANTIES OR CONDITIONS OF ANY KIND, either express or implied.
* See the License for the specific language governing permissions and
* limitations under the License.
*******************************************************************************/

#ifndef _PSE846GPS2DBZC4A_S_H_
#define _PSE846GPS2DBZC4A_S_H_

/**
* \addtogroup group_device PSE846GPS2DBZC4A
* \{
*/

/**
* \addtogroup Configuration_of_CMSIS
* \{
*/

/*******************************************************************************
*                         Interrupt Number Definition
*******************************************************************************/

typedef enum {
#if defined(COMPONENT_CM0P)
  /* ARM Cortex-M0+ Core Interrupt Numbers */
  Reset_IRQn                        = -15,      /*!< -15 Reset Vector, invoked on Power up and warm reset */
  NonMaskableInt_IRQn               = -14,      /*!< -14 Non maskable Interrupt, cannot be stopped or preempted */
  HardFault_IRQn                    = -13,      /*!< -13 Hard Fault, all classes of Fault */
  SVCall_IRQn                       =  -5,      /*!<  -5 System Service Call via SVC instruction */
  PendSV_IRQn                       =  -2,      /*!<  -2 Pendable request for system service */
  SysTick_IRQn                      =  -1,      /*!<  -1 System Tick Timer */
  /* CM0PLUS Peripheral Interrupt Numbers */
  m33syscpuss_interrupts_ipc_dpslp_0_IRQn =   1, /*!<   1 [DeepSleep] m33syscpuss Inter Process Communication Interrupt #0 */
  m33syscpuss_interrupts_ipc_dpslp_1_IRQn =   2, /*!<   2 [DeepSleep] m33syscpuss Inter Process Communication Interrupt #1 */
  m33syscpuss_interrupts_ipc_dpslp_2_IRQn =   3, /*!<   3 [DeepSleep] m33syscpuss Inter Process Communication Interrupt #2 */
  m33syscpuss_interrupts_ipc_dpslp_3_IRQn =   4, /*!<   4 [DeepSleep] m33syscpuss Inter Process Communication Interrupt #3 */
  m33syscpuss_interrupts_ipc_dpslp_4_IRQn =   5, /*!<   5 [DeepSleep] m33syscpuss Inter Process Communication Interrupt #4 */
  m33syscpuss_interrupts_ipc_dpslp_5_IRQn =   6, /*!<   6 [DeepSleep] m33syscpuss Inter Process Communication Interrupt #5 */
  m33syscpuss_interrupts_ipc_dpslp_6_IRQn =   7, /*!<   7 [DeepSleep] m33syscpuss Inter Process Communication Interrupt #6 */
  m33syscpuss_interrupts_ipc_dpslp_7_IRQn =   8, /*!<   8 [DeepSleep] m33syscpuss Inter Process Communication Interrupt #7 */
  unconnected_IRQn                  =1023       /*!< 1023 Unconnected */
#elif defined(COMPONENT_CM33)
  /* ARM Cortex-M33 Core Interrupt Numbers */
  Reset_IRQn                        = -15,      /*!< -15 Reset Vector, invoked on Power up and warm reset */
  NonMaskableInt_IRQn               = -14,      /*!< -14 Non maskable Interrupt, cannot be stopped or preempted */
  HardFault_IRQn                    = -13,      /*!< -13 Hard Fault, all classes of Fault */
  MemoryManagement_IRQn             = -12,      /*!< -12 Memory Management, MPU mismatch, including Access Violation and No Match */
  BusFault_IRQn                     = -11,      /*!< -11 Bus Fault, Pre-Fetch-, Memory Access Fault, other address/memory related Fault */
  UsageFault_IRQn                   = -10,      /*!< -10 Usage Fault, i.e. Undef Instruction, Illegal State Transition */
  SecureFault_IRQn                  =  -9,      /*!<  -9 Secure Fault Interrupt */
  SVCall_IRQn                       =  -5,      /*!<  -5 System Service Call via SVC instruction */
  DebugMonitor_IRQn                 =  -4,      /*!<  -4 Debug Monitor */
  PendSV_IRQn                       =  -2,      /*!<  -2 Pendable request for system service */
  SysTick_IRQn                      =  -1,      /*!<  -1 System Tick Timer */
  /* CM33 Peripheral Interrupt Numbers */
  ioss_interrupts_gpio_0_IRQn       =   0,      /*!<   0 [DeepSleep] GPIO Port Interrupt #0 */
  ioss_interrupts_gpio_2_IRQn       =   1,      /*!<   1 [DeepSleep] GPIO Port Interrupt #2 */
  ioss_interrupts_gpio_3_IRQn       =   2,      /*!<   2 [DeepSleep] GPIO Port Interrupt #3 */
  ioss_interrupts_gpio_5_IRQn       =   3,      /*!<   3 [DeepSleep] GPIO Port Interrupt #5 */
  ioss_interrupts_gpio_6_IRQn       =   4,      /*!<   4 [DeepSleep] GPIO Port Interrupt #6 */
  ioss_interrupts_gpio_7_IRQn       =   5,      /*!<   5 [DeepSleep] GPIO Port Interrupt #7 */
  ioss_interrupts_gpio_8_IRQn       =   6,      /*!<   6 [DeepSleep] GPIO Port Interrupt #8 */
  ioss_interrupts_gpio_9_IRQn       =   7,      /*!<   7 [DeepSleep] GPIO Port Interrupt #9 */
  ioss_interrupts_gpio_10_IRQn      =   8,      /*!<   8 [DeepSleep] GPIO Port Interrupt #10 */
  ioss_interrupts_gpio_11_IRQn      =   9,      /*!<   9 [DeepSleep] GPIO Port Interrupt #11 */
  ioss_interrupts_gpio_12_IRQn      =  10,      /*!<  10 [DeepSleep] GPIO Port Interrupt #12 */
  ioss_interrupts_gpio_13_IRQn      =  11,      /*!<  11 [DeepSleep] GPIO Port Interrupt #13 */
  ioss_interrupts_gpio_14_IRQn      =  12,      /*!<  12 [DeepSleep] GPIO Port Interrupt #14 */
  ioss_interrupts_gpio_15_IRQn      =  13,      /*!<  13 [DeepSleep] GPIO Port Interrupt #15 */
  ioss_interrupts_gpio_16_IRQn      =  14,      /*!<  14 [DeepSleep] GPIO Port Interrupt #16 */
  ioss_interrupts_gpio_17_IRQn      =  15,      /*!<  15 [DeepSleep] GPIO Port Interrupt #17 */
  ioss_interrupts_gpio_18_IRQn      =  16,      /*!<  16 [DeepSleep] GPIO Port Interrupt #18 */
  ioss_interrupts_gpio_19_IRQn      =  17,      /*!<  17 [DeepSleep] GPIO Port Interrupt #19 */
  ioss_interrupts_gpio_20_IRQn      =  18,      /*!<  18 [DeepSleep] GPIO Port Interrupt #20 */
  ioss_interrupts_gpio_21_IRQn      =  19,      /*!<  19 [DeepSleep] GPIO Port Interrupt #21 */
  ioss_interrupts_sec_gpio_0_IRQn   =  20,      /*!<  20 [DeepSleep] GPIO Port Secure Interrupt #0 */
  ioss_interrupts_sec_gpio_2_IRQn   =  21,      /*!<  21 [DeepSleep] GPIO Port Secure Interrupt #2 */
  ioss_interrupts_sec_gpio_3_IRQn   =  22,      /*!<  22 [DeepSleep] GPIO Port Secure Interrupt #3 */
  ioss_interrupts_sec_gpio_5_IRQn   =  23,      /*!<  23 [DeepSleep] GPIO Port Secure Interrupt #5 */
  ioss_interrupts_sec_gpio_6_IRQn   =  24,      /*!<  24 [DeepSleep] GPIO Port Secure Interrupt #6 */
  ioss_interrupts_sec_gpio_7_IRQn   =  25,      /*!<  25 [DeepSleep] GPIO Port Secure Interrupt #7 */
  ioss_interrupts_sec_gpio_8_IRQn   =  26,      /*!<  26 [DeepSleep] GPIO Port Secure Interrupt #8 */
  ioss_interrupts_sec_gpio_9_IRQn   =  27,      /*!<  27 [DeepSleep] GPIO Port Secure Interrupt #9 */
  ioss_interrupts_sec_gpio_10_IRQn  =  28,      /*!<  28 [DeepSleep] GPIO Port Secure Interrupt #10 */
  ioss_interrupts_sec_gpio_11_IRQn  =  29,      /*!<  29 [DeepSleep] GPIO Port Secure Interrupt #11 */
  ioss_interrupts_sec_gpio_12_IRQn  =  30,      /*!<  30 [DeepSleep] GPIO Port Secure Interrupt #12 */
  ioss_interrupts_sec_gpio_13_IRQn  =  31,      /*!<  31 [DeepSleep] GPIO Port Secure Interrupt #13 */
  ioss_interrupts_sec_gpio_14_IRQn  =  32,      /*!<  32 [DeepSleep] GPIO Port Secure Interrupt #14 */
  ioss_interrupts_sec_gpio_15_IRQn  =  33,      /*!<  33 [DeepSleep] GPIO Port Secure Interrupt #15 */
  ioss_interrupts_sec_gpio_16_IRQn  =  34,      /*!<  34 [DeepSleep] GPIO Port Secure Interrupt #16 */
  ioss_interrupts_sec_gpio_17_IRQn  =  35,      /*!<  35 [DeepSleep] GPIO Port Secure Interrupt #17 */
  ioss_interrupts_sec_gpio_18_IRQn  =  36,      /*!<  36 [DeepSleep] GPIO Port Secure Interrupt #18 */
  ioss_interrupts_sec_gpio_19_IRQn  =  37,      /*!<  37 [DeepSleep] GPIO Port Secure Interrupt #19 */
  ioss_interrupts_sec_gpio_20_IRQn  =  38,      /*!<  38 [DeepSleep] GPIO Port Secure Interrupt #20 */
  ioss_interrupts_sec_gpio_21_IRQn  =  39,      /*!<  39 [DeepSleep] GPIO Port Secure Interrupt #21 */
  ioss_interrupt_vdd_IRQn           =  40,      /*!<  40 [DeepSleep] GPIO Supply Detect Interrupt */
  ioss_interrupt_gpio_IRQn          =  41,      /*!<  41 [DeepSleep] GPIO All Ports */
  ioss_interrupt_sec_gpio_IRQn      =  42,      /*!<  42 [DeepSleep] GPIO All Ports - Secured version */
  scb_0_interrupt_IRQn              =  43,      /*!<  43 [DeepSleep] Serial Communication Block #0 (DeepSleep capable) */
  srss_interrupt_IRQn               =  44,      /*!<  44 [DeepSleep] Other combined Interrupts for srss (LVD, CLKCAL) */
  lpcomp_interrupt_IRQn             =  45,      /*!<  45 [DeepSleep] LPCOMP */
  m55appcpuss_interrupts_ipc_dpslp_0_IRQn =  46, /*!<  46 [DeepSleep] m55appcpuss Inter Process Communication Interrupt #0 */
  m55appcpuss_interrupts_ipc_dpslp_1_IRQn =  47, /*!<  47 [DeepSleep] m55appcpuss Inter Process Communication Interrupt #1 */
  m55appcpuss_interrupts_ipc_dpslp_2_IRQn =  48, /*!<  48 [DeepSleep] m55appcpuss Inter Process Communication Interrupt #2 */
  m55appcpuss_interrupts_ipc_dpslp_3_IRQn =  49, /*!<  49 [DeepSleep] m55appcpuss Inter Process Communication Interrupt #3 */
  m55appcpuss_interrupts_ipc_dpslp_4_IRQn =  50, /*!<  50 [DeepSleep] m55appcpuss Inter Process Communication Interrupt #4 */
  m55appcpuss_interrupts_ipc_dpslp_5_IRQn =  51, /*!<  51 [DeepSleep] m55appcpuss Inter Process Communication Interrupt #5 */
  m55appcpuss_interrupts_ipc_dpslp_6_IRQn =  52, /*!<  52 [DeepSleep] m55appcpuss Inter Process Communication Interrupt #6 */
  m55appcpuss_interrupts_ipc_dpslp_7_IRQn =  53, /*!<  53 [DeepSleep] m55appcpuss Inter Process Communication Interrupt #7 */
  srss_interrupt_wdt_IRQn           =  54,      /*!<  54 [DeepSleep] Interrupt for WDT */
  srss_interrupt_mcwdt_0_IRQn       =  55,      /*!<  55 [DeepSleep] Interrupt for MCWDT[] */
  srss_interrupt_rtc_IRQn           =  56,      /*!<  56 [DeepSleep] Interrupt for RTC */
  pass_interrupt_lppass_IRQn        =  57,      /*!<  57 [DeepSleep] LPPASS interrupt */
  pass_interrupt_fifo_IRQn          =  58,      /*!<  58 [DeepSleep] LPPASS FIFO interrupt */
  ioss_interrupts_gpio_1_IRQn       =  59,      /*!<  59 [Active] GPIO Port Interrupt #1 (SMIF0) */
  ioss_interrupts_gpio_4_IRQn       =  60,      /*!<  60 [Active] GPIO Port Interrupt #4 (SMIF1) */
  srss_interrupt_main_ppu_IRQn      =  63,      /*!<  63 [Active] Interrupt from Main PPU */
  srss_interrupt_srss_pd1_ppu_IRQn  =  64,      /*!<  64 [Active] Interrupt from PD1 PPU */
  m33syscpuss_interrupt_ppu_sramc0_IRQn =  65,  /*!<  65 [Active] PPU SRAM0 */
  m33syscpuss_interrupt_ppu_sramc1_IRQn =  66,  /*!<  66 [Active] PPU SRAM1 */
  m33syscpuss_interrupt_ppu_cpuss_IRQn =  67,   /*!<  67 [Active] cpuss[0] PPU Interrupt */
  mxu55_interrupt_ppu_IRQn          =  68,      /*!<  68 [Active] Interrupt requests of mxu55.PPU */
  socmem_interrupt_ppu_IRQn         =  69,      /*!<  69 [Active] Interrupt requests of socmem.PPU */
  m33syscpuss_interrupts_ipc_dpslp_0_IRQn =  70, /*!<  70 [Active] m33syscpuss Inter Process Communication Interrupt #0 */
  m33syscpuss_interrupts_ipc_dpslp_1_IRQn =  71, /*!<  71 [Active] m33syscpuss Inter Process Communication Interrupt #1 */
  m33syscpuss_interrupts_ipc_dpslp_2_IRQn =  72, /*!<  72 [Active] m33syscpuss Inter Process Communication Interrupt #2 */
  m33syscpuss_interrupts_ipc_dpslp_3_IRQn =  73, /*!<  73 [Active] m33syscpuss Inter Process Communication Interrupt #3 */
  m33syscpuss_interrupts_ipc_dpslp_4_IRQn =  74, /*!<  74 [Active] m33syscpuss Inter Process Communication Interrupt #4 */
  m33syscpuss_interrupts_ipc_dpslp_5_IRQn =  75, /*!<  75 [Active] m33syscpuss Inter Process Communication Interrupt #5 */
  m33syscpuss_interrupts_ipc_dpslp_6_IRQn =  76, /*!<  76 [Active] m33syscpuss Inter Process Communication Interrupt #6 */
  m33syscpuss_interrupts_ipc_dpslp_7_IRQn =  77, /*!<  77 [Active] m33syscpuss Inter Process Communication Interrupt #7 */
  mxnnlite_interrupt_mxnnlite_IRQn  =  78,      /*!<  78 [Active] Interrupt of MXNNLITE */
  m33syscpuss_interrupts_cm33_0_cti_0_IRQn =  79, /*!<  79 [Active]  */
  m33syscpuss_interrupts_cm33_0_cti_1_IRQn =  80, /*!<  80 [Active]  */
  m33syscpuss_interrupt_cm33_0_fp_IRQn =  81,   /*!<  81 [Active] CM33 0 Floating Point Interrupt */
  m33syscpuss_interrupts_dw0_0_IRQn =  82,      /*!<  82 [Active] cpuss[0] DataWire #0, Channel #0 */
  m33syscpuss_interrupts_dw0_1_IRQn =  83,      /*!<  83 [Active] cpuss[0] DataWire #0, Channel #1 */
  m33syscpuss_interrupts_dw0_2_IRQn =  84,      /*!<  84 [Active] cpuss[0] DataWire #0, Channel #2 */
  m33syscpuss_interrupts_dw0_3_IRQn =  85,      /*!<  85 [Active] cpuss[0] DataWire #0, Channel #3 */
  m33syscpuss_interrupts_dw0_4_IRQn =  86,      /*!<  86 [Active] cpuss[0] DataWire #0, Channel #4 */
  m33syscpuss_interrupts_dw0_5_IRQn =  87,      /*!<  87 [Active] cpuss[0] DataWire #0, Channel #5 */
  m33syscpuss_interrupts_dw0_6_IRQn =  88,      /*!<  88 [Active] cpuss[0] DataWire #0, Channel #6 */
  m33syscpuss_interrupts_dw0_7_IRQn =  89,      /*!<  89 [Active] cpuss[0] DataWire #0, Channel #7 */
  m33syscpuss_interrupts_dw0_8_IRQn =  90,      /*!<  90 [Active] cpuss[0] DataWire #0, Channel #8 */
  m33syscpuss_interrupts_dw0_9_IRQn =  91,      /*!<  91 [Active] cpuss[0] DataWire #0, Channel #9 */
  m33syscpuss_interrupts_dw0_10_IRQn =  92,     /*!<  92 [Active] cpuss[0] DataWire #0, Channel #10 */
  m33syscpuss_interrupts_dw0_11_IRQn =  93,     /*!<  93 [Active] cpuss[0] DataWire #0, Channel #11 */
  m33syscpuss_interrupts_dw0_12_IRQn =  94,     /*!<  94 [Active] cpuss[0] DataWire #0, Channel #12 */
  m33syscpuss_interrupts_dw0_13_IRQn =  95,     /*!<  95 [Active] cpuss[0] DataWire #0, Channel #13 */
  m33syscpuss_interrupts_dw0_14_IRQn =  96,     /*!<  96 [Active] cpuss[0] DataWire #0, Channel #14 */
  m33syscpuss_interrupts_dw0_15_IRQn =  97,     /*!<  97 [Active] cpuss[0] DataWire #0, Channel #15 */
  m55appcpuss_interrupts_axidmac_0_IRQn =  98,  /*!<  98 [Active]  */
  m55appcpuss_interrupts_axidmac_1_IRQn =  99,  /*!<  99 [Active]  */
  m55appcpuss_interrupts_axidmac_2_IRQn = 100,  /*!< 100 [Active]  */
  m55appcpuss_interrupts_axidmac_3_IRQn = 101,  /*!< 101 [Active]  */
  smif_0_smif0_interrupt_nsec_IRQn  = 102,      /*!< 102 [Active] SMIF0 Port0 non-secure interrupt */
  smif_0_smif0_interrupt_sec_IRQn   = 103,      /*!< 103 [Active] SMIF0 Port0 secure interrupt */
  smif_1_smif0_interrupt_nsec_IRQn  = 104,      /*!< 104 [Active] SMIF1 Port0 non-secure interrupt */
  smif_1_smif0_interrupt_sec_IRQn   = 105,      /*!< 105 [Active] SMIF1 Port0 secure interrupt */
  canfd_0_interrupts0_0_IRQn        = 106,      /*!< 106 [Active] CAN #0, Interrupt0, Channel#0 */
  canfd_0_interrupts1_0_IRQn        = 107,      /*!< 107 [Active] CAN #0, Interrupt1, Channel#0 */
  canfd_0_interrupts0_1_IRQn        = 108,      /*!< 108 [Active] CAN #0, Interrupt0, Channel#1 */
  canfd_0_interrupts1_1_IRQn        = 109,      /*!< 109 [Active] CAN #0, Interrupt1, Channel#1 */
  tcpwm_0_interrupts_0_IRQn         = 110,      /*!< 110 [Active] TCPWM, 32-bit Counter #0 */
  tcpwm_0_interrupts_1_IRQn         = 111,      /*!< 111 [Active] TCPWM, 32-bit Counter #1 */
  tcpwm_0_interrupts_2_IRQn         = 112,      /*!< 112 [Active] TCPWM, 32-bit Counter #2 */
  tcpwm_0_interrupts_3_IRQn         = 113,      /*!< 113 [Active] TCPWM, 32-bit Counter #3 */
  tcpwm_0_interrupts_4_IRQn         = 114,      /*!< 114 [Active] TCPWM, 32-bit Counter #4 */
  tcpwm_0_interrupts_5_IRQn         = 115,      /*!< 115 [Active] TCPWM, 32-bit Counter #5 */
  tcpwm_0_interrupts_6_IRQn         = 116,      /*!< 116 [Active] TCPWM, 32-bit Counter #6 */
  tcpwm_0_interrupts_7_IRQn         = 117,      /*!< 117 [Active] TCPWM, 32-bit Counter #7 */
  tcpwm_0_interrupts_256_IRQn       = 118,      /*!< 118 [Active] TCPWM, 16-bit Counter #0 */
  tcpwm_0_interrupts_257_IRQn       = 119,      /*!< 119 [Active] TCPWM, 16-bit Counter #1 */
  tcpwm_0_interrupts_258_IRQn       = 120,      /*!< 120 [Active] TCPWM, 16-bit Counter #2 */
  tcpwm_0_interrupts_259_IRQn       = 121,      /*!< 121 [Active] TCPWM, 16-bit Counter #3 */
  tcpwm_0_interrupts_260_IRQn       = 122,      /*!< 122 [Active] TCPWM, 16-bit Counter #4 */
  tcpwm_0_interrupts_261_IRQn       = 123,      /*!< 123 [Active] TCPWM, 16-bit Counter #5 */
  tcpwm_0_interrupts_262_IRQn       = 124,      /*!< 124 [Active] TCPWM, 16-bit Counter #6 */
  tcpwm_0_interrupts_263_IRQn       = 125,      /*!< 125 [Active] TCPWM, 16-bit Counter #7 */
  tcpwm_0_interrupts_264_IRQn       = 126,      /*!< 126 [Active] TCPWM, 16-bit Counter #8 */
  tcpwm_0_interrupts_265_IRQn       = 127,      /*!< 127 [Active] TCPWM, 16-bit Counter #9 */
  tcpwm_0_interrupts_266_IRQn       = 128,      /*!< 128 [Active] TCPWM, 16-bit Counter #10 */
  tcpwm_0_interrupts_267_IRQn       = 129,      /*!< 129 [Active] TCPWM, 16-bit Counter #11 */
  tcpwm_0_interrupts_268_IRQn       = 130,      /*!< 130 [Active] TCPWM, 16-bit Counter #12 */
  tcpwm_0_interrupts_269_IRQn       = 131,      /*!< 131 [Active] TCPWM, 16-bit Counter #13 */
  tcpwm_0_interrupts_270_IRQn       = 132,      /*!< 132 [Active] TCPWM, 16-bit Counter #14 */
  tcpwm_0_interrupts_271_IRQn       = 133,      /*!< 133 [Active] TCPWM, 16-bit Counter #15 */
  tcpwm_0_interrupts_272_IRQn       = 134,      /*!< 134 [Active] TCPWM, 16-bit Counter #16 */
  tcpwm_0_interrupts_273_IRQn       = 135,      /*!< 135 [Active] TCPWM, 16-bit Counter #17 */
  tcpwm_0_interrupts_274_IRQn       = 136,      /*!< 136 [Active] TCPWM, 16-bit Counter #18 */
  tcpwm_0_interrupts_275_IRQn       = 137,      /*!< 137 [Active] TCPWM, 16-bit Counter #19 */
  tcpwm_0_interrupts_276_IRQn       = 138,      /*!< 138 [Active] TCPWM, 16-bit Counter #20 */
  tcpwm_0_interrupts_277_IRQn       = 139,      /*!< 139 [Active] TCPWM, 16-bit Counter #21 */
  tcpwm_0_interrupts_278_IRQn       = 140,      /*!< 140 [Active] TCPWM, 16-bit Counter #22 */
  tcpwm_0_interrupts_279_IRQn       = 141,      /*!< 141 [Active] TCPWM, 16-bit Counter #23 */
  scb_1_interrupt_IRQn              = 142,      /*!< 142 [Active] SCB#1 Interrupt */
  scb_2_interrupt_IRQn              = 143,      /*!< 143 [Active] SCB#2 Interrupt */
  scb_3_interrupt_IRQn              = 144,      /*!< 144 [Active] SCB#3 Interrupt */
  scb_4_interrupt_IRQn              = 145,      /*!< 145 [Active] SCB#4 Interrupt */
  scb_5_interrupt_IRQn              = 146,      /*!< 146 [Active] SCB#5 Interrupt */
  scb_6_interrupt_IRQn              = 147,      /*!< 147 [Active] SCB#6 Interrupt */
  scb_7_interrupt_IRQn              = 148,      /*!< 148 [Active] SCB#7 Interrupt */
  scb_8_interrupt_IRQn              = 149,      /*!< 149 [Active] SCB#8 Interrupt */
  scb_9_interrupt_IRQn              = 150,      /*!< 150 [Active] SCB#9 Interrupt */
  scb_10_interrupt_IRQn             = 151,      /*!< 151 [Active] SCB#10 Interrupt */
  scb_11_interrupt_IRQn             = 152,      /*!< 152 [Active] SCB#11 Interrupt */
  mxu55_interrupt_npu_IRQn          = 153,      /*!< 153 [Active] Interrupt requests of armu55 (NPU) */
  sdhc_0_interrupt_general_IRQn     = 154,      /*!< 154 [Active] SDHC0 */
  sdhc_0_interrupt_wakeup_IRQn      = 155,      /*!< 155 [Active] SDHC0 */
  sdhc_1_interrupt_general_IRQn     = 156,      /*!< 156 [Active] SDHC1 */
  sdhc_1_interrupt_wakeup_IRQn      = 157,      /*!< 157 [Active] SDHC1 */
  tdm_0_interrupts_rx_0_IRQn        = 158,      /*!< 158 [Active] TDM0 Audio interrupt RX Structure#0 */
  tdm_0_interrupts_tx_0_IRQn        = 159,      /*!< 159 [Active] TDM0 Audio interrupt TX Structure#0 */
  tdm_0_interrupts_rx_1_IRQn        = 160,      /*!< 160 [Active] TDM0 Audio interrupt RX Structure#1 */
  tdm_0_interrupts_tx_1_IRQn        = 161,      /*!< 161 [Active] TDM0 Audio interrupt TX Structure#1 */
  gfxss_interrupt_gpu_IRQn          = 162,      /*!< 162 [Active] Interrupt from GPU. */
  gfxss_interrupt_dc_IRQn           = 163,      /*!< 163 [Active] Interrupt from DC. */
  gfxss_interrupt_mipidsi_IRQn      = 164,      /*!< 164 [Active] Interrupt from MIPIDSI. */
  pdm_0_interrupts_0_IRQn           = 165,      /*!< 165 [Active] PDM interrupt Structure#0 */
  pdm_0_interrupts_1_IRQn           = 166,      /*!< 166 [Active] PDM interrupt Structure#1 */
  pdm_0_interrupts_2_IRQn           = 167,      /*!< 167 [Active] PDM interrupt Structure#2 */
  pdm_0_interrupts_3_IRQn           = 168,      /*!< 168 [Active] PDM interrupt Structure#3 */
  pdm_0_interrupts_4_IRQn           = 169,      /*!< 169 [Active] PDM interrupt Structure#4 */
  pdm_0_interrupts_5_IRQn           = 170,      /*!< 170 [Active] PDM interrupt Structure#5 */
  eth_interrupt_eth_0_IRQn          = 171,      /*!< 171 [Active] ETH Interrupt#0 */
  eth_interrupt_eth_1_IRQn          = 172,      /*!< 172 [Active] ETH Interrupt#1 */
  eth_interrupt_eth_2_IRQn          = 173,      /*!< 173 [Active] ETH Interrupt#2 */
  usbhs_interrupt_usbhsctrl_IRQn    = 174,      /*!< 174 [Active] Interrupt of Controller core */
  usbhs_interrupt_usbhsss_IRQn      = 175,      /*!< 175 [Active] Interrupt of Subsystem */
  i3c_interrupt_IRQn                = 176,      /*!< 176 [Active] I3C Interrupt */
  m33syscpuss_interrupt_msc_IRQn    = 177,      /*!< 177 [Active]  */
  crypto_interrupt_IRQn             = 178,      /*!< 178 [Active] Crypto Interrupt */
  m33syscpuss_interrupts_fault_0_IRQn = 179,    /*!< 179 [Active]  */
  m33syscpuss_interrupts_fault_1_IRQn = 180,    /*!< 180 [Active]  */
  m33syscpuss_interrupts_dw1_0_IRQn = 181,      /*!< 181 [Active] cpuss[0] DataWire #1, Channel #0 */
  m33syscpuss_interrupts_dw1_1_IRQn = 182,      /*!< 182 [Active] cpuss[0] DataWire #1, Channel #1 */
  m33syscpuss_interrupts_dw1_2_IRQn = 183,      /*!< 183 [Active] cpuss[0] DataWire #1, Channel #2 */
  m33syscpuss_interrupts_dw1_3_IRQn = 184,      /*!< 184 [Active] cpuss[0] DataWire #1, Channel #3 */
  m33syscpuss_interrupts_dw1_4_IRQn = 185,      /*!< 185 [Active] cpuss[0] DataWire #1, Channel #4 */
  m33syscpuss_interrupts_dw1_5_IRQn = 186,      /*!< 186 [Active] cpuss[0] DataWire #1, Channel #5 */
  m33syscpuss_interrupts_dw1_6_IRQn = 187,      /*!< 187 [Active] cpuss[0] DataWire #1, Channel #6 */
  m33syscpuss_interrupts_dw1_7_IRQn = 188,      /*!< 188 [Active] cpuss[0] DataWire #1, Channel #7 */
  m33syscpuss_interrupts_dw1_8_IRQn = 189,      /*!< 189 [Active] cpuss[0] DataWire #1, Channel #8 */
  m33syscpuss_interrupts_dw1_9_IRQn = 190,      /*!< 190 [Active] cpuss[0] DataWire #1, Channel #9 */
  m33syscpuss_interrupts_dw1_10_IRQn = 191,     /*!< 191 [Active] cpuss[0] DataWire #1, Channel #10 */
  m33syscpuss_interrupts_dw1_11_IRQn = 192,     /*!< 192 [Active] cpuss[0] DataWire #1, Channel #11 */
  m33syscpuss_interrupts_dw1_12_IRQn = 193,     /*!< 193 [Active] cpuss[0] DataWire #1, Channel #12 */
  m33syscpuss_interrupts_dw1_13_IRQn = 194,     /*!< 194 [Active] cpuss[0] DataWire #1, Channel #13 */
  m33syscpuss_interrupts_dw1_14_IRQn = 195,     /*!< 195 [Active] cpuss[0] DataWire #1, Channel #14 */
  m33syscpuss_interrupts_dw1_15_IRQn = 196,     /*!< 196 [Active] cpuss[0] DataWire #1, Channel #15 */
  unconnected_IRQn                  =1023       /*!< 1023 Unconnected */
#elif defined(COMPONENT_CM55)
  /* ARM Cortex-M55 Core Interrupt Numbers */
  Reset_IRQn                        = -15,      /*!< -15 Reset Vector, invoked on Power up and warm reset */
  NonMaskableInt_IRQn               = -14,      /*!< -14 Non maskable Interrupt, cannot be stopped or preempted */
  HardFault_IRQn                    = -13,      /*!< -13 Hard Fault, all classes of Fault */
  MemoryManagement_IRQn             = -12,      /*!< -12 Memory Management, MPU mismatch, including Access Violation and No Match */
  BusFault_IRQn                     = -11,      /*!< -11 Bus Fault, Pre-Fetch-, Memory Access Fault, other address/memory related Fault */
  UsageFault_IRQn                   = -10,      /*!< -10 Usage Fault, i.e. Undef Instruction, Illegal State Transition */
  SecureFault_IRQn                  =  -9,      /*!<  -9 Secure Fault Interrupt */
  SVCall_IRQn                       =  -5,      /*!<  -5 System Service Call via SVC instruction */
  DebugMonitor_IRQn                 =  -4,      /*!<  -4 Debug Monitor */
  PendSV_IRQn                       =  -2,      /*!<  -2 Pendable request for system service */
  SysTick_IRQn                      =  -1,      /*!<  -1 System Tick Timer */
  /* CM55 Peripheral Interrupt Numbers */
  ioss_interrupts_gpio_0_IRQn       =   0,      /*!<   0 [DeepSleep] GPIO Port Interrupt #0 */
  ioss_interrupts_gpio_2_IRQn       =   1,      /*!<   1 [DeepSleep] GPIO Port Interrupt #2 */
  ioss_interrupts_gpio_3_IRQn       =   2,      /*!<   2 [DeepSleep] GPIO Port Interrupt #3 */
  ioss_interrupts_gpio_5_IRQn       =   3,      /*!<   3 [DeepSleep] GPIO Port Interrupt #5 */
  ioss_interrupts_gpio_6_IRQn       =   4,      /*!<   4 [DeepSleep] GPIO Port Interrupt #6 */
  ioss_interrupts_gpio_7_IRQn       =   5,      /*!<   5 [DeepSleep] GPIO Port Interrupt #7 */
  ioss_interrupts_gpio_8_IRQn       =   6,      /*!<   6 [DeepSleep] GPIO Port Interrupt #8 */
  ioss_interrupts_gpio_9_IRQn       =   7,      /*!<   7 [DeepSleep] GPIO Port Interrupt #9 */
  ioss_interrupts_gpio_10_IRQn      =   8,      /*!<   8 [DeepSleep] GPIO Port Interrupt #10 */
  ioss_interrupts_gpio_11_IRQn      =   9,      /*!<   9 [DeepSleep] GPIO Port Interrupt #11 */
  ioss_interrupts_gpio_12_IRQn      =  10,      /*!<  10 [DeepSleep] GPIO Port Interrupt #12 */
  ioss_interrupts_gpio_13_IRQn      =  11,      /*!<  11 [DeepSleep] GPIO Port Interrupt #13 */
  ioss_interrupts_gpio_14_IRQn      =  12,      /*!<  12 [DeepSleep] GPIO Port Interrupt #14 */
  ioss_interrupts_gpio_15_IRQn      =  13,      /*!<  13 [DeepSleep] GPIO Port Interrupt #15 */
  ioss_interrupts_gpio_16_IRQn      =  14,      /*!<  14 [DeepSleep] GPIO Port Interrupt #16 */
  ioss_interrupts_gpio_17_IRQn      =  15,      /*!<  15 [DeepSleep] GPIO Port Interrupt #17 */
  ioss_interrupts_gpio_18_IRQn      =  16,      /*!<  16 [DeepSleep] GPIO Port Interrupt #18 */
  ioss_interrupts_gpio_19_IRQn      =  17,      /*!<  17 [DeepSleep] GPIO Port Interrupt #19 */
  ioss_interrupts_gpio_20_IRQn      =  18,      /*!<  18 [DeepSleep] GPIO Port Interrupt #20 */
  ioss_interrupts_gpio_21_IRQn      =  19,      /*!<  19 [DeepSleep] GPIO Port Interrupt #21 */
  ioss_interrupt_vdd_IRQn           =  20,      /*!<  20 [DeepSleep] GPIO Supply Detect Interrupt */
  ioss_interrupt_gpio_IRQn          =  21,      /*!<  21 [DeepSleep] GPIO All Ports */
  scb_0_interrupt_IRQn              =  22,      /*!<  22 [DeepSleep] Serial Communication Block #0 (DeepSleep capable) */
  srss_interrupt_IRQn               =  23,      /*!<  23 [DeepSleep] Other combined Interrupts for srss (LVD, CLKCAL) */
  lpcomp_interrupt_IRQn             =  24,      /*!<  24 [DeepSleep] LPCOMP */
  m33syscpuss_interrupts_ipc_dpslp_0_IRQn =  25, /*!<  25 [DeepSleep] m33syscpuss Inter Process Communication Interrupt #0 */
  m33syscpuss_interrupts_ipc_dpslp_1_IRQn =  26, /*!<  26 [DeepSleep] m33syscpuss Inter Process Communication Interrupt #1 */
  m33syscpuss_interrupts_ipc_dpslp_2_IRQn =  27, /*!<  27 [DeepSleep] m33syscpuss Inter Process Communication Interrupt #2 */
  m33syscpuss_interrupts_ipc_dpslp_3_IRQn =  28, /*!<  28 [DeepSleep] m33syscpuss Inter Process Communication Interrupt #3 */
  m33syscpuss_interrupts_ipc_dpslp_4_IRQn =  29, /*!<  29 [DeepSleep] m33syscpuss Inter Process Communication Interrupt #4 */
  m33syscpuss_interrupts_ipc_dpslp_5_IRQn =  30, /*!<  30 [DeepSleep] m33syscpuss Inter Process Communication Interrupt #5 */
  m33syscpuss_interrupts_ipc_dpslp_6_IRQn =  31, /*!<  31 [DeepSleep] m33syscpuss Inter Process Communication Interrupt #6 */
  m33syscpuss_interrupts_ipc_dpslp_7_IRQn =  32, /*!<  32 [DeepSleep] m33syscpuss Inter Process Communication Interrupt #7 */
  srss_interrupt_wdt_IRQn           =  33,      /*!<  33 [DeepSleep] Interrupt for WDT */
  srss_interrupt_mcwdt_1_IRQn       =  34,      /*!<  34 [DeepSleep] Interrupt for MCWDT[] */
  srss_interrupt_rtc_IRQn           =  35,      /*!<  35 [DeepSleep] Interrupt from RTC */
  pass_interrupt_lppass_IRQn        =  36,      /*!<  36 [DeepSleep] LPPASS interrupt */
  pass_interrupt_fifo_IRQn          =  37,      /*!<  37 [DeepSleep] LPPASS FIFO interrupt */
  mxu55_interrupt_npu_IRQn          =  38,      /*!<  38 [DeepSleep] Interrupt requests of armu55 (NPU) */
  ioss_interrupts_gpio_1_IRQn       =  39,      /*!<  39 [Active] GPIO Port Interrupt #1 */
  ioss_interrupts_gpio_4_IRQn       =  40,      /*!<  40 [Active] GPIO Port Interrupt #4 */
  srss_interrupt_main_ppu_IRQn      =  41,      /*!<  41 [Active] Interrupt from Main PPU */
  srss_interrupt_srss_pd1_ppu_IRQn  =  42,      /*!<  42 [Active] Interrupt from PD1 PPU */
  m55appcpuss_interrupt_ppu_appcpuss_IRQn =  43, /*!<  43 [Active] PPU APPCPUSS */
  m55appcpuss_interrupt_ppu_cm55_0_IRQn =  44,  /*!<  44 [Active] PPU CM55 */
  mxu55_interrupt_ppu_IRQn          =  45,      /*!<  45 [Active] Interrupt requests of mxu55.PPU */
  socmem_interrupt_ppu_IRQn         =  46,      /*!<  46 [Active] Interrupt requests of socmem.PPU */
  m55appcpuss_interrupts_ipc_dpslp_0_IRQn =  47, /*!<  47 [Active] m55appcpuss Inter Process Communication Interrupt #0 */
  m55appcpuss_interrupts_ipc_dpslp_1_IRQn =  48, /*!<  48 [Active] m55appcpuss Inter Process Communication Interrupt #1 */
  m55appcpuss_interrupts_ipc_dpslp_2_IRQn =  49, /*!<  49 [Active] m55appcpuss Inter Process Communication Interrupt #2 */
  m55appcpuss_interrupts_ipc_dpslp_3_IRQn =  50, /*!<  50 [Active] m55appcpuss Inter Process Communication Interrupt #3 */
  m55appcpuss_interrupts_ipc_dpslp_4_IRQn =  51, /*!<  51 [Active] m55appcpuss Inter Process Communication Interrupt #4 */
  m55appcpuss_interrupts_ipc_dpslp_5_IRQn =  52, /*!<  52 [Active] m55appcpuss Inter Process Communication Interrupt #5 */
  m55appcpuss_interrupts_ipc_dpslp_6_IRQn =  53, /*!<  53 [Active] m55appcpuss Inter Process Communication Interrupt #6 */
  m55appcpuss_interrupts_ipc_dpslp_7_IRQn =  54, /*!<  54 [Active] m55appcpuss Inter Process Communication Interrupt #7 */
  mxnnlite_interrupt_mxnnlite_IRQn  =  55,      /*!<  55 [Active] Interrupt of MXNNLITE */
  m55appcpuss_interrupt_cm55_0_fp_IRQn =  56,   /*!<  56 [Active] CM33 0 Floating Point Interrupt */
  m55appcpuss_interrupts_cm55_0_cti_0_IRQn =  57, /*!<  57 [Active]  */
  m55appcpuss_interrupts_cm55_0_cti_1_IRQn =  58, /*!<  58 [Active]  */
  m55appcpuss_interrupt_msc_IRQn    =  59,      /*!<  59 [Active]  */
  m33syscpuss_interrupts_dw0_0_IRQn =  60,      /*!<  60 [Active] cpuss[0] DataWire #0, Channel #0 */
  m33syscpuss_interrupts_dw0_1_IRQn =  61,      /*!<  61 [Active] cpuss[0] DataWire #0, Channel #1 */
  m33syscpuss_interrupts_dw0_2_IRQn =  62,      /*!<  62 [Active] cpuss[0] DataWire #0, Channel #2 */
  m33syscpuss_interrupts_dw0_3_IRQn =  63,      /*!<  63 [Active] cpuss[0] DataWire #0, Channel #3 */
  m33syscpuss_interrupts_dw0_4_IRQn =  64,      /*!<  64 [Active] cpuss[0] DataWire #0, Channel #4 */
  m33syscpuss_interrupts_dw0_5_IRQn =  65,      /*!<  65 [Active] cpuss[0] DataWire #0, Channel #5 */
  m33syscpuss_interrupts_dw0_6_IRQn =  66,      /*!<  66 [Active] cpuss[0] DataWire #0, Channel #6 */
  m33syscpuss_interrupts_dw0_7_IRQn =  67,      /*!<  67 [Active] cpuss[0] DataWire #0, Channel #7 */
  m33syscpuss_interrupts_dw0_8_IRQn =  68,      /*!<  68 [Active] cpuss[0] DataWire #0, Channel #8 */
  m33syscpuss_interrupts_dw0_9_IRQn =  69,      /*!<  69 [Active] cpuss[0] DataWire #0, Channel #9 */
  m33syscpuss_interrupts_dw0_10_IRQn =  70,     /*!<  70 [Active] cpuss[0] DataWire #0, Channel #10 */
  m33syscpuss_interrupts_dw0_11_IRQn =  71,     /*!<  71 [Active] cpuss[0] DataWire #0, Channel #11 */
  m33syscpuss_interrupts_dw0_12_IRQn =  72,     /*!<  72 [Active] cpuss[0] DataWire #0, Channel #12 */
  m33syscpuss_interrupts_dw0_13_IRQn =  73,     /*!<  73 [Active] cpuss[0] DataWire #0, Channel #13 */
  m33syscpuss_interrupts_dw0_14_IRQn =  74,     /*!<  74 [Active] cpuss[0] DataWire #0, Channel #14 */
  m33syscpuss_interrupts_dw0_15_IRQn =  75,     /*!<  75 [Active] cpuss[0] DataWire #0, Channel #15 */
  m55appcpuss_interrupts_axidmac_0_IRQn =  76,  /*!<  76 [Active]  */
  m55appcpuss_interrupts_axidmac_1_IRQn =  77,  /*!<  77 [Active]  */
  m55appcpuss_interrupts_axidmac_2_IRQn =  78,  /*!<  78 [Active]  */
  m55appcpuss_interrupts_axidmac_3_IRQn =  79,  /*!<  79 [Active]  */
  smif_0_smif0_interrupt_nsec_IRQn  =  80,      /*!<  80 [Active] SMIF0 Port0 non-secure interrupt */
  smif_0_smif0_interrupt_sec_IRQn   =  81,      /*!<  81 [Active] SMIF0 Port0 secure interrupt */
  smif_1_smif0_interrupt_nsec_IRQn  =  82,      /*!<  82 [Active] SMIF1 Port0 non-secure interrupt */
  smif_1_smif0_interrupt_sec_IRQn   =  83,      /*!<  83 [Active] SMIF1 Port0 secure interrupt */
  canfd_0_interrupts0_0_IRQn        =  84,      /*!<  84 [Active] CAN #0, Interrupt0, Channel#0 */
  canfd_0_interrupts1_0_IRQn        =  85,      /*!<  85 [Active] CAN #0, Interrupt1, Channel#0 */
  canfd_0_interrupts0_1_IRQn        =  86,      /*!<  86 [Active] CAN #0, Interrupt0, Channel#1 */
  canfd_0_interrupts1_1_IRQn        =  87,      /*!<  87 [Active] CAN #0, Interrupt1, Channel#1 */
  tcpwm_0_interrupts_0_IRQn         =  88,      /*!<  88 [Active] TCPWM, 32-bit Counter #0 */
  tcpwm_0_interrupts_1_IRQn         =  89,      /*!<  89 [Active] TCPWM, 32-bit Counter #1 */
  tcpwm_0_interrupts_2_IRQn         =  90,      /*!<  90 [Active] TCPWM, 32-bit Counter #2 */
  tcpwm_0_interrupts_3_IRQn         =  91,      /*!<  91 [Active] TCPWM, 32-bit Counter #3 */
  tcpwm_0_interrupts_4_IRQn         =  92,      /*!<  92 [Active] TCPWM, 32-bit Counter #4 */
  tcpwm_0_interrupts_5_IRQn         =  93,      /*!<  93 [Active] TCPWM, 32-bit Counter #5 */
  tcpwm_0_interrupts_6_IRQn         =  94,      /*!<  94 [Active] TCPWM, 32-bit Counter #6 */
  tcpwm_0_interrupts_7_IRQn         =  95,      /*!<  95 [Active] TCPWM, 32-bit Counter #7 */
  tcpwm_0_interrupts_256_IRQn       =  96,      /*!<  96 [Active] TCPWM, 16-bit Counter #0 */
  tcpwm_0_interrupts_257_IRQn       =  97,      /*!<  97 [Active] TCPWM, 16-bit Counter #1 */
  tcpwm_0_interrupts_258_IRQn       =  98,      /*!<  98 [Active] TCPWM, 16-bit Counter #2 */
  tcpwm_0_interrupts_259_IRQn       =  99,      /*!<  99 [Active] TCPWM, 16-bit Counter #3 */
  tcpwm_0_interrupts_260_IRQn       = 100,      /*!< 100 [Active] TCPWM, 16-bit Counter #4 */
  tcpwm_0_interrupts_261_IRQn       = 101,      /*!< 101 [Active] TCPWM, 16-bit Counter #5 */
  tcpwm_0_interrupts_262_IRQn       = 102,      /*!< 102 [Active] TCPWM, 16-bit Counter #6 */
  tcpwm_0_interrupts_263_IRQn       = 103,      /*!< 103 [Active] TCPWM, 16-bit Counter #7 */
  tcpwm_0_interrupts_264_IRQn       = 104,      /*!< 104 [Active] TCPWM, 16-bit Counter #8 */
  tcpwm_0_interrupts_265_IRQn       = 105,      /*!< 105 [Active] TCPWM, 16-bit Counter #9 */
  tcpwm_0_interrupts_266_IRQn       = 106,      /*!< 106 [Active] TCPWM, 16-bit Counter #10 */
  tcpwm_0_interrupts_267_IRQn       = 107,      /*!< 107 [Active] TCPWM, 16-bit Counter #11 */
  tcpwm_0_interrupts_268_IRQn       = 108,      /*!< 108 [Active] TCPWM, 16-bit Counter #12 */
  tcpwm_0_interrupts_269_IRQn       = 109,      /*!< 109 [Active] TCPWM, 16-bit Counter #13 */
  tcpwm_0_interrupts_270_IRQn       = 110,      /*!< 110 [Active] TCPWM, 16-bit Counter #14 */
  tcpwm_0_interrupts_271_IRQn       = 111,      /*!< 111 [Active] TCPWM, 16-bit Counter #15 */
  tcpwm_0_interrupts_272_IRQn       = 112,      /*!< 112 [Active] TCPWM, 16-bit Counter #16 */
  tcpwm_0_interrupts_273_IRQn       = 113,      /*!< 113 [Active] TCPWM, 16-bit Counter #17 */
  tcpwm_0_interrupts_274_IRQn       = 114,      /*!< 114 [Active] TCPWM, 16-bit Counter #18 */
  tcpwm_0_interrupts_275_IRQn       = 115,      /*!< 115 [Active] TCPWM, 16-bit Counter #19 */
  tcpwm_0_interrupts_276_IRQn       = 116,      /*!< 116 [Active] TCPWM, 16-bit Counter #20 */
  tcpwm_0_interrupts_277_IRQn       = 117,      /*!< 117 [Active] TCPWM, 16-bit Counter #21 */
  tcpwm_0_interrupts_278_IRQn       = 118,      /*!< 118 [Active] TCPWM, 16-bit Counter #22 */
  tcpwm_0_interrupts_279_IRQn       = 119,      /*!< 119 [Active] TCPWM, 16-bit Counter #23 */
  scb_1_interrupt_IRQn              = 120,      /*!< 120 [Active] SCB#1 Interrupt */
  scb_2_interrupt_IRQn              = 121,      /*!< 121 [Active] SCB#2 Interrupt */
  scb_3_interrupt_IRQn              = 122,      /*!< 122 [Active] SCB#3 Interrupt */
  scb_4_interrupt_IRQn              = 123,      /*!< 123 [Active] SCB#4 Interrupt */
  scb_5_interrupt_IRQn              = 124,      /*!< 124 [Active] SCB#5 Interrupt */
  scb_6_interrupt_IRQn              = 125,      /*!< 125 [Active] SCB#6 Interrupt */
  scb_7_interrupt_IRQn              = 126,      /*!< 126 [Active] SCB#7 Interrupt */
  scb_8_interrupt_IRQn              = 127,      /*!< 127 [Active] SCB#8 Interrupt */
  scb_9_interrupt_IRQn              = 128,      /*!< 128 [Active] SCB#9 Interrupt */
  scb_10_interrupt_IRQn             = 129,      /*!< 129 [Active] SCB#10 Interrupt */
  scb_11_interrupt_IRQn             = 130,      /*!< 130 [Active] SCB#11 Interrupt */
  sdhc_0_interrupt_general_IRQn     = 131,      /*!< 131 [Active] SDHC0 */
  sdhc_0_interrupt_wakeup_IRQn      = 132,      /*!< 132 [Active] SDHC0 */
  sdhc_1_interrupt_general_IRQn     = 133,      /*!< 133 [Active] SDHC1 */
  sdhc_1_interrupt_wakeup_IRQn      = 134,      /*!< 134 [Active] SDHC1 */
  tdm_0_interrupts_rx_0_IRQn        = 135,      /*!< 135 [Active] TDM0 Audio interrupt RX Structure#0 */
  tdm_0_interrupts_tx_0_IRQn        = 136,      /*!< 136 [Active] TDM0 Audio interrupt TX Structure#0 */
  tdm_0_interrupts_rx_1_IRQn        = 137,      /*!< 137 [Active] TDM0 Audio interrupt RX Structure#1 */
  tdm_0_interrupts_tx_1_IRQn        = 138,      /*!< 138 [Active] TDM0 Audio interrupt TX Structure#1 */
  gfxss_interrupt_gpu_IRQn          = 139,      /*!< 139 [Active] Interrupt from GPU. */
  gfxss_interrupt_dc_IRQn           = 140,      /*!< 140 [Active] Interrupt from DC. */
  gfxss_interrupt_mipidsi_IRQn      = 141,      /*!< 141 [Active] Interrupt from MIPIDSI. */
  pdm_0_interrupts_0_IRQn           = 142,      /*!< 142 [Active] PDM interrupt Structure#0 */
  pdm_0_interrupts_1_IRQn           = 143,      /*!< 143 [Active] PDM interrupt Structure#1 */
  pdm_0_interrupts_2_IRQn           = 144,      /*!< 144 [Active] PDM interrupt Structure#2 */
  pdm_0_interrupts_3_IRQn           = 145,      /*!< 145 [Active] PDM interrupt Structure#3 */
  pdm_0_interrupts_4_IRQn           = 146,      /*!< 146 [Active] PDM interrupt Structure#4 */
  pdm_0_interrupts_5_IRQn           = 147,      /*!< 147 [Active] PDM interrupt Structure#5 */
  eth_interrupt_eth_0_IRQn          = 148,      /*!< 148 [Active] ETH Interrupt#0 */
  eth_interrupt_eth_1_IRQn          = 149,      /*!< 149 [Active] ETH Interrupt#1 */
  eth_interrupt_eth_2_IRQn          = 150,      /*!< 150 [Active] ETH Interrupt#2 */
  usbhs_interrupt_usbhsctrl_IRQn    = 151,      /*!< 151 [Active] Interrupt of Controller core */
  usbhs_interrupt_usbhsss_IRQn      = 152,      /*!< 152 [Active] Interrupt of Subsystem */
  i3c_interrupt_IRQn                = 153,      /*!< 153 [Active] I3C Interrupt */
  crypto_interrupt_IRQn             = 154,      /*!< 154 [Active] Crypto Interrupt */
  m33syscpuss_interrupts_fault_0_IRQn = 155,    /*!< 155 [Active]  */
  m33syscpuss_interrupts_fault_1_IRQn = 156,    /*!< 156 [Active]  */
  m55appcpuss_interrupt_ahb2axi_buff_err_IRQn = 157, /*!< 157 [Active] Interrupt from xhb500 ahb to axi bridge */
  m33syscpuss_interrupts_dw1_0_IRQn = 158,      /*!< 158 [Active] cpuss[0] DataWire #1, Channel #0 */
  m33syscpuss_interrupts_dw1_1_IRQn = 159,      /*!< 159 [Active] cpuss[0] DataWire #1, Channel #1 */
  m33syscpuss_interrupts_dw1_2_IRQn = 160,      /*!< 160 [Active] cpuss[0] DataWire #1, Channel #2 */
  m33syscpuss_interrupts_dw1_3_IRQn = 161,      /*!< 161 [Active] cpuss[0] DataWire #1, Channel #3 */
  m33syscpuss_interrupts_dw1_4_IRQn = 162,      /*!< 162 [Active] cpuss[0] DataWire #1, Channel #4 */
  m33syscpuss_interrupts_dw1_5_IRQn = 163,      /*!< 163 [Active] cpuss[0] DataWire #1, Channel #5 */
  m33syscpuss_interrupts_dw1_6_IRQn = 164,      /*!< 164 [Active] cpuss[0] DataWire #1, Channel #6 */
  m33syscpuss_interrupts_dw1_7_IRQn = 165,      /*!< 165 [Active] cpuss[0] DataWire #1, Channel #7 */
  m33syscpuss_interrupts_dw1_8_IRQn = 166,      /*!< 166 [Active] cpuss[0] DataWire #1, Channel #8 */
  m33syscpuss_interrupts_dw1_9_IRQn = 167,      /*!< 167 [Active] cpuss[0] DataWire #1, Channel #9 */
  m33syscpuss_interrupts_dw1_10_IRQn = 168,     /*!< 168 [Active] cpuss[0] DataWire #1, Channel #10 */
  m33syscpuss_interrupts_dw1_11_IRQn = 169,     /*!< 169 [Active] cpuss[0] DataWire #1, Channel #11 */
  m33syscpuss_interrupts_dw1_12_IRQn = 170,     /*!< 170 [Active] cpuss[0] DataWire #1, Channel #12 */
  m33syscpuss_interrupts_dw1_13_IRQn = 171,     /*!< 171 [Active] cpuss[0] DataWire #1, Channel #13 */
  m33syscpuss_interrupts_dw1_14_IRQn = 172,     /*!< 172 [Active] cpuss[0] DataWire #1, Channel #14 */
  m33syscpuss_interrupts_dw1_15_IRQn = 173,     /*!< 173 [Active] cpuss[0] DataWire #1, Channel #15 */
  unconnected_IRQn                  =1023       /*!< 1023 Unconnected */
#endif
} IRQn_Type;


/*******************************************************************************
*                    Processor and Core Peripheral Section
*******************************************************************************/

#if defined(COMPONENT_CM0P)
/* Configuration of the ARM Cortex-M0+ Processor and Core Peripherals */
#define __CM0PLUS_REV                   0x0001U /*!< CM0PLUS Core Revision */
#define __NVIC_PRIO_BITS                3       /*!< Number of Bits used for Priority Levels */
#define __Vendor_SysTickConfig          0       /*!< Set to 1 if different SysTick Config is used */
#define __VTOR_PRESENT                  1       /*!< Set to 1 if CPU supports Vector Table Offset Register */
#define __MPU_PRESENT                   1       /*!< MPU present or not */

/** \} Configuration_of_CMSIS */

#include "core_cm0plus.h"                       /*!< ARM Cortex-M0+ processor and core peripherals */

#elif defined(COMPONENT_CM33)
/* Configuration of the ARM Cortex-M33 Processor and Core Peripherals */
#define __CM33_REV                      0x0001U /*!< CM33 Core Revision */
#define __NVIC_PRIO_BITS                3       /*!< Number of Bits used for Priority Levels */
#define __Vendor_SysTickConfig          0       /*!< Set to 1 if different SysTick Config is used */
#define __VTOR_PRESENT                  1       /*!< Set to 1 if CPU supports Vector Table Offset Register */
#define __MPU_PRESENT                   1       /*!< MPU present or not */
#define __FPU_PRESENT                   1       /*!< FPU present or not */
#define __CM0P_PRESENT                  0       /*!< CM0P present or not */
#define __DTCM_PRESENT                  0       /*!< Data Tightly Coupled Memory is present or not */
#define __ICACHE_PRESENT                0       /*!< Instruction Cache present or not */
#define __DCACHE_PRESENT                0       /*!< Data Cache present or not */
#define __DSP_PRESENT                   1       /*!< DSP extension present or not */
#define __SAUREGION_PRESENT             1       /*!< SAU regions present or not */

/** \} Configuration_of_CMSIS */

#include "core_cm33.h"                          /*!< ARM Cortex-M33 processor and core peripherals */

#elif defined(COMPONENT_CM55)
/* Configuration of the ARM Cortex-M55 Processor and Core Peripherals */
#define __CM55_REV                      0x0002U /*!< CM55 Core Revision */
#define __NVIC_PRIO_BITS                3       /*!< Number of Bits used for Priority Levels */
#define __Vendor_SysTickConfig          0       /*!< Set to 1 if different SysTick Config is used */
#define __VTOR_PRESENT                  1       /*!< Set to 1 if CPU supports Vector Table Offset Register */
#define __MPU_PRESENT                   1       /*!< MPU present or not */
#define __FPU_PRESENT                   1       /*!< FPU present or not */
#define __CM0P_PRESENT                  0       /*!< CM0P present or not */
#define __DTCM_PRESENT                  1       /*!< Data Tightly Coupled Memory is present or not */
#define __ICACHE_PRESENT                1       /*!< Instruction Cache present or not */
#define __DCACHE_PRESENT                1       /*!< Data Cache present or not */
#define __DSP_PRESENT                   1       /*!< DSP extension present or not */
#define __SAUREGION_PRESENT             0       /*!< SAU regions present or not */

/** \} Configuration_of_CMSIS */

#include "core_cm55.h"                          /*!< ARM Cortex-M55 processor and core peripherals */

#endif

/* Memory Blocks */
#define CY_ROM_M0_BASE                  0x10000000UL
#define CY_ROM_M0_CBUS_BASE             0x10000000UL
#define CY_ROM_M0_SIZE                  0x00010000UL
#define CY_ROM_M0_NS_SBUS_BASE          0x00000000UL
#define CY_ROM_M0_NS_CBUS_BASE          0x00000000UL
#define CY_ROM_M0_S_SBUS_BASE           0x10000000UL
#define CY_ROM_M0_S_CBUS_BASE           0x10000000UL
#define CY_CM55_ITCM_INTERNAL_BASE      0x10000000UL
#define CY_CM55_ITCM_INTERNAL_CBUS_BASE 0x10000000UL
#define CY_CM55_ITCM_INTERNAL_SIZE      0x00040000UL
#define CY_CM55_ITCM_INTERNAL_NS_SBUS_BASE 0x00000000UL
#define CY_CM55_ITCM_INTERNAL_NS_CBUS_BASE 0x00000000UL
#define CY_CM55_ITCM_INTERNAL_S_SBUS_BASE 0x10000000UL
#define CY_CM55_ITCM_INTERNAL_S_CBUS_BASE 0x10000000UL
#define CY_CM55_DTCM_INTERNAL_BASE      0x30000000UL
#define CY_CM55_DTCM_INTERNAL_SIZE      0x00040000UL
#define CY_CM55_DTCM_INTERNAL_NS_SBUS_BASE 0x20000000UL
#define CY_CM55_DTCM_INTERNAL_S_SBUS_BASE 0x30000000UL
#define CY_RRAM_BASE                    0x32000000UL
#define CY_RRAM_CBUS_BASE               0x12000000UL
#define CY_RRAM_SIZE                    0x00080000UL
#define CY_RRAM_NS_SBUS_BASE            0x22000000UL
#define CY_RRAM_NS_CBUS_BASE            0x02000000UL
#define CY_RRAM_S_SBUS_BASE             0x32000000UL
#define CY_RRAM_S_CBUS_BASE             0x12000000UL
#define CY_SOCMEM_RAM_BASE              0x36000000UL
#define CY_SOCMEM_RAM_CBUS_BASE         0x16000000UL
#define CY_SOCMEM_RAM_SIZE              0x00500000UL
#define CY_SOCMEM_RAM_NS_SBUS_BASE      0x26000000UL
#define CY_SOCMEM_RAM_NS_CBUS_BASE      0x06000000UL
#define CY_SOCMEM_RAM_S_SBUS_BASE       0x36000000UL
#define CY_SOCMEM_RAM_S_CBUS_BASE       0x16000000UL
#define CY_CAN0MRAM_BASE                0x52850000UL
#define CY_CAN0MRAM_CBUS_BASE           0x52850000UL
#define CY_CAN0MRAM_SIZE                0x00010000UL
#define CY_CAN0MRAM_NS_SBUS_BASE        0x42850000UL
#define CY_CAN0MRAM_NS_CBUS_BASE        0x42850000UL
#define CY_CAN0MRAM_S_SBUS_BASE         0x52850000UL
#define CY_CAN0MRAM_S_CBUS_BASE         0x52850000UL
#define CY_CM55_ITCM_BASE               0x58000000UL
#define CY_CM55_ITCM_CBUS_BASE          0x78000000UL
#define CY_CM55_ITCM_SIZE               0x00040000UL
#define CY_CM55_ITCM_NS_SBUS_BASE       0x48000000UL
#define CY_CM55_ITCM_NS_CBUS_BASE       0x68000000UL
#define CY_CM55_ITCM_S_SBUS_BASE        0x58000000UL
#define CY_CM55_ITCM_S_CBUS_BASE        0x78000000UL
#define CY_CM55_DTCM_BASE               0x58040000UL
#define CY_CM55_DTCM_CBUS_BASE          0x78040000UL
#define CY_CM55_DTCM_SIZE               0x00040000UL
#define CY_CM55_DTCM_NS_SBUS_BASE       0x48040000UL
#define CY_CM55_DTCM_NS_CBUS_BASE       0x68040000UL
#define CY_CM55_DTCM_S_SBUS_BASE        0x58040000UL
#define CY_CM55_DTCM_S_CBUS_BASE        0x78040000UL
#define CY_XIP_PORT0_BASE               0x70000000UL
#define CY_XIP_PORT0_CBUS_BASE          0x18000000UL
#define CY_XIP_PORT0_SIZE               0x04000000UL
#define CY_XIP_PORT0_NS_SBUS_BASE       0x60000000UL
#define CY_XIP_PORT0_NS_CBUS_BASE       0x08000000UL
#define CY_XIP_PORT0_S_SBUS_BASE        0x70000000UL
#define CY_XIP_PORT0_S_CBUS_BASE        0x18000000UL
#define CY_XIP_PORT1_BASE               0x74000000UL
#define CY_XIP_PORT1_CBUS_BASE          0x1C000000UL
#define CY_XIP_PORT1_SIZE               0x04000000UL
#define CY_XIP_PORT1_NS_SBUS_BASE       0x64000000UL
#define CY_XIP_PORT1_NS_CBUS_BASE       0x0C000000UL
#define CY_XIP_PORT1_S_SBUS_BASE        0x74000000UL
#define CY_XIP_PORT1_S_CBUS_BASE        0x1C000000UL
#define CY_SRAM_BASE                    0x34000000UL
#define CY_SRAM_CBUS_BASE               0x14000000UL
#define CY_SRAM_SIZE                    0x00100000UL
#define CY_SRAM_NS_SBUS_BASE            0x24000000UL
#define CY_SRAM_NS_CBUS_BASE            0x04000000UL
#define CY_SRAM_S_SBUS_BASE             0x34000000UL
#define CY_SRAM_S_CBUS_BASE             0x14000000UL


/* IP List */
#define CY_IP_MXTTCANFD                 1u
#define CY_IP_MXTTCANFD_INSTANCES       1u
#define CY_IP_MXTTCANFD_VERSION         4u
#define CY_IP_MXTTCANFD_VERSION_MINOR   0u
#define CY_IP_MXCRYPTO                  1u
#define CY_IP_MXCRYPTO_INSTANCES        1u
#define CY_IP_MXCRYPTO_VERSION          2u
#define CY_IP_MXCRYPTO_VERSION_MINOR    1u
#define CY_IP_MXDEBUG600                1u
#define CY_IP_MXDEBUG600_INSTANCES      1u
#define CY_IP_MXDEBUG600_VERSION        1u
#define CY_IP_MXDEBUG600_VERSION_MINOR  2u
#define CY_IP_MXDFT                     1u
#define CY_IP_MXDFT_INSTANCES           1u
#define CY_IP_MXDFT_VERSION             3u
#define CY_IP_MXDFT_VERSION_MINOR       1u
#define CY_IP_MXETH                     1u
#define CY_IP_MXETH_INSTANCES           1u
#define CY_IP_MXETH_VERSION             3u
#define CY_IP_MXETH_VERSION_MINOR       0u
#define CY_IP_MXS22GFXSS                1u
#define CY_IP_MXS22GFXSS_INSTANCES      1u
#define CY_IP_MXS22GFXSS_VERSION        1u
#define CY_IP_MXS22GFXSS_VERSION_MINOR  0u
#define CY_IP_MXI3C                     1u
#define CY_IP_MXI3C_INSTANCES           1u
#define CY_IP_MXI3C_VERSION             1u
#define CY_IP_MXI3C_VERSION_MINOR       1u
#define CY_IP_MXS22IOSS                 1u
#define CY_IP_MXS22IOSS_INSTANCES       1u
#define CY_IP_MXS22IOSS_VERSION         1u
#define CY_IP_MXS22IOSS_VERSION_MINOR   0u
#define CY_IP_MXS22LPCOMP               1u
#define CY_IP_MXS22LPCOMP_INSTANCES     1u
#define CY_IP_MXS22LPCOMP_VERSION       1u
#define CY_IP_MXS22LPCOMP_VERSION_MINOR 0u
#define CY_IP_M0SECCPUSS                1u
#define CY_IP_M0SECCPUSS_INSTANCES      1u
#define CY_IP_M0SECCPUSS_VERSION        2u
#define CY_IP_M0SECCPUSS_VERSION_MINOR  0u
#define CY_IP_M33SYSCPUSS               1u
#define CY_IP_M33SYSCPUSS_INSTANCES     1u
#define CY_IP_M33SYSCPUSS_VERSION       2u
#define CY_IP_M33SYSCPUSS_VERSION_MINOR 2u
#define CY_IP_M55APPCPUSS               1u
#define CY_IP_M55APPCPUSS_INSTANCES     1u
#define CY_IP_M55APPCPUSS_VERSION       1u
#define CY_IP_M55APPCPUSS_VERSION_MINOR 1u
#define CY_IP_MXCM33                    1u
#define CY_IP_MXCM33_INSTANCES          1u
#define CY_IP_MXCM33_VERSION            2u
#define CY_IP_MXCM33_VERSION_MINOR      1u
#define CY_IP_MXCM55                    1u
#define CY_IP_MXCM55_INSTANCES          1u
#define CY_IP_MXCM55_VERSION            1u
#define CY_IP_MXCM55_VERSION_MINOR      0u
#define CY_IP_MXDW                      1u
#define CY_IP_MXDW_INSTANCES            2u
#define CY_IP_MXDW_VERSION              1u
#define CY_IP_MXDW_VERSION_MINOR        0u
#define CY_IP_MXFAULT                   1u
#define CY_IP_MXFAULT_INSTANCES         1u
#define CY_IP_MXFAULT_VERSION           1u
#define CY_IP_MXFAULT_VERSION_MINOR     0u
#define CY_IP_MXIPC                     1u
#define CY_IP_MXIPC_INSTANCES           2u
#define CY_IP_MXIPC_VERSION             1u
#define CY_IP_MXIPC_VERSION_MINOR       0u
#define CY_IP_MXNNLITE                  1u
#define CY_IP_MXNNLITE_INSTANCES        1u
#define CY_IP_MXNNLITE_VERSION          2u
#define CY_IP_MXNNLITE_VERSION_MINOR    0u
#define CY_IP_MXS22RRAMC                1u
#define CY_IP_MXS22RRAMC_INSTANCES      1u
#define CY_IP_MXS22RRAMC_VERSION        1u
#define CY_IP_MXS22RRAMC_VERSION_MINOR  0u
#define CY_IP_MXSRAMC                   1u
#define CY_IP_MXSRAMC_INSTANCES         2u
#define CY_IP_MXSRAMC_VERSION           2u
#define CY_IP_MXSRAMC_VERSION_MINOR     1u
#define CY_IP_MXU55                     1u
#define CY_IP_MXU55_INSTANCES           1u
#define CY_IP_MXU55_VERSION             1u
#define CY_IP_MXU55_VERSION_MINOR       0u
#define CY_IP_MXS22LPPASS               1u
#define CY_IP_MXS22LPPASS_INSTANCES     1u
#define CY_IP_MXS22LPPASS_VERSION       1u
#define CY_IP_MXS22LPPASS_VERSION_MINOR 1u
#define CY_IP_MXS22LPPASS_SAR           1u
#define CY_IP_MXS22LPPASS_SAR_INSTANCES 1u
#define CY_IP_MXS22LPPASS_SAR_VERSION   1u
#define CY_IP_MXS22LPPASS_SAR_VERSION_MINOR 1u
#define CY_IP_MXS22LPPASS_DAC           1u
#define CY_IP_MXS22LPPASS_DAC_INSTANCES 2u
#define CY_IP_MXS22LPPASS_DAC_VERSION   1u
#define CY_IP_MXS22LPPASS_DAC_VERSION_MINOR 1u
#define CY_IP_MXS22LPPASS_PTC           1u
#define CY_IP_MXS22LPPASS_PTC_INSTANCES 1u
#define CY_IP_MXS22LPPASS_PTC_VERSION   1u
#define CY_IP_MXS22LPPASS_PTC_VERSION_MINOR 1u
#define CY_IP_MXS22LPPASS_CTB           1u
#define CY_IP_MXS22LPPASS_CTB_INSTANCES 2u
#define CY_IP_MXS22LPPASS_CTB_VERSION   1u
#define CY_IP_MXS22LPPASS_CTB_VERSION_MINOR 1u
#define CY_IP_MXPDM                     1u
#define CY_IP_MXPDM_INSTANCES           1u
#define CY_IP_MXPDM_VERSION             1u
#define CY_IP_MXPDM_VERSION_MINOR       1u
#define CY_IP_MXSPERI                   1u
#define CY_IP_MXSPERI_INSTANCES         2u
#define CY_IP_MXSPERI_VERSION           2u
#define CY_IP_MXSPERI_VERSION_MINOR     1u
#define CY_IP_MXSPERI_TR                1u
#define CY_IP_MXSPERI_TR_INSTANCES      1u
#define CY_IP_MXSPERI_TR_VERSION        2u
#define CY_IP_MXSPERI_TR_VERSION_MINOR  1u
#define CY_IP_MXSAXIDMAC                1u
#define CY_IP_MXSAXIDMAC_INSTANCES      1u
#define CY_IP_MXSAXIDMAC_VERSION        1u
#define CY_IP_MXSAXIDMAC_VERSION_MINOR  0u
#define CY_IP_MXS22SCB                  1u
#define CY_IP_MXS22SCB_INSTANCES        12u
#define CY_IP_MXS22SCB_VERSION          1u
#define CY_IP_MXS22SCB_VERSION_MINOR    0u
#define CY_IP_MXSDHC                    1u
#define CY_IP_MXSDHC_INSTANCES          2u
#define CY_IP_MXSDHC_VERSION            2u
#define CY_IP_MXSDHC_VERSION_MINOR      0u
#define CY_IP_MXSMIF                    1u
#define CY_IP_MXSMIF_INSTANCES          2u
#define CY_IP_MXSMIF_VERSION            6u
#define CY_IP_MXSMIF_VERSION_MINOR      0u
#define CY_IP_MXSOCMEM                  1u
#define CY_IP_MXSOCMEM_INSTANCES        1u
#define CY_IP_MXSOCMEM_VERSION          1u
#define CY_IP_MXSOCMEM_VERSION_MINOR    0u
#define CY_IP_MXS22SRSS                 1u
#define CY_IP_MXS22SRSS_INSTANCES       1u
#define CY_IP_MXS22SRSS_VERSION         1u
#define CY_IP_MXS22SRSS_VERSION_MINOR   1u
#define CY_IP_MXTCPWM                   1u
#define CY_IP_MXTCPWM_INSTANCES         1u
#define CY_IP_MXTCPWM_VERSION           2u
#define CY_IP_MXTCPWM_VERSION_MINOR     0u
#define CY_IP_MXTDM                     1u
#define CY_IP_MXTDM_INSTANCES           1u
#define CY_IP_MXTDM_VERSION             3u
#define CY_IP_MXTDM_VERSION_MINOR       0u
#define CY_IP_MXS22USBHS                1u
#define CY_IP_MXS22USBHS_INSTANCES      1u
#define CY_IP_MXS22USBHS_VERSION        1u
#define CY_IP_MXS22USBHS_VERSION_MINOR  0u

#define CY_DEVICE_PSE84
#define CY_DEVICE_SERIES_PSE8XXGP
#define CY_DEVICE_IFX_SECURITY_EPC2
#define CY_PDL_TZ_ENABLED
#define CY_SILICON_ID                   0xED942115UL
#define CY_HF_CLK_MAX_FREQ              400000000UL


#include "system_edge.h"

#include "pse84_config.h"
#include "gpio_pse84_bga_220.h"

/*******************************************************************************
*                                   MAIN_NVM
*******************************************************************************/

#define MAIN_NVM_BASE                           0x12000000UL
#define MAIN_NVM                                ((MAIN_NVM_Type*) MAIN_NVM_BASE)                                  /* 0x12000000 */

/*******************************************************************************
*                              NON_SECURE_SFLASH
*******************************************************************************/

#define NON_SECURE_SFLASH_BASE                  0x13C2B000UL
#define NON_SECURE_SFLASH                       ((NON_SECURE_SFLASH_Type*) NON_SECURE_SFLASH_BASE)                /* 0x13C2B000 */

/*******************************************************************************
*                                     PERI
*******************************************************************************/

#define PERI0_BASE                              0x52000000UL
#define PERI1_BASE                              0x54000000UL
#define PERI0                                   ((PERI_Type*) PERI0_BASE)                                         /* 0x52000000 */
#define PERI1                                   ((PERI_Type*) PERI1_BASE)                                         /* 0x54000000 */
#define PERI0_GR0                               ((PERI_GR_Type*) &PERI0->GR[0])                                   /* 0x52004000 */
#define PERI0_GR1                               ((PERI_GR_Type*) &PERI0->GR[1])                                   /* 0x52004040 */
#define PERI0_GR2                               ((PERI_GR_Type*) &PERI0->GR[2])                                   /* 0x52004080 */
#define PERI0_GR3                               ((PERI_GR_Type*) &PERI0->GR[3])                                   /* 0x520040C0 */
#define PERI0_GR4                               ((PERI_GR_Type*) &PERI0->GR[4])                                   /* 0x52004100 */
#define PERI0_GR5                               ((PERI_GR_Type*) &PERI0->GR[5])                                   /* 0x52004140 */
#define PERI1_GR0                               ((PERI_GR_Type*) &PERI1->GR[0])                                   /* 0x54004000 */
#define PERI1_GR1                               ((PERI_GR_Type*) &PERI1->GR[1])                                   /* 0x54004040 */
#define PERI1_GR2                               ((PERI_GR_Type*) &PERI1->GR[2])                                   /* 0x54004080 */
#define PERI1_GR3                               ((PERI_GR_Type*) &PERI1->GR[3])                                   /* 0x540040C0 */
#define PERI1_GR4                               ((PERI_GR_Type*) &PERI1->GR[4])                                   /* 0x54004100 */
#define PERI0_TR_GR0                            ((PERI_TR_GR_Type*) &PERI0->TR_GR[0])                             /* 0x52008000 */
#define PERI0_TR_GR1                            ((PERI_TR_GR_Type*) &PERI0->TR_GR[1])                             /* 0x52008400 */
#define PERI0_TR_GR2                            ((PERI_TR_GR_Type*) &PERI0->TR_GR[2])                             /* 0x52008800 */
#define PERI0_TR_GR3                            ((PERI_TR_GR_Type*) &PERI0->TR_GR[3])                             /* 0x52008C00 */
#define PERI0_TR_GR4                            ((PERI_TR_GR_Type*) &PERI0->TR_GR[4])                             /* 0x52009000 */
#define PERI0_TR_GR5                            ((PERI_TR_GR_Type*) &PERI0->TR_GR[5])                             /* 0x52009400 */
#define PERI1_TR_GR0                            ((PERI_TR_GR_Type*) &PERI1->TR_GR[0])                             /* 0x54008000 */
#define PERI1_TR_GR1                            ((PERI_TR_GR_Type*) &PERI1->TR_GR[1])                             /* 0x54008400 */
#define PERI1_TR_GR2                            ((PERI_TR_GR_Type*) &PERI1->TR_GR[2])                             /* 0x54008800 */
#define PERI0_TR_1TO1_GR0                       ((PERI_TR_1TO1_GR_Type*) &PERI0->TR_1TO1_GR[0])                   /* 0x5200C000 */

/*******************************************************************************
*                                     PPC
*******************************************************************************/
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
