jphacks/tka_2601/PSOC_Edge_E84/source/voice_stream.c

#include "voice_stream.h"
#include "voice_transport.h"
#include "voice_settings.h"
#include "e84_network.h"
#include "e84_shared.h"
#include "m5_settings.h"
#include "m5_link.h"
#include "cy_wcm.h"
#include <stdio.h>
#include <string.h>
#include <limits.h>

typedef enum { STARTING, CONNECT_AGENT, WAIT_REPLY, PLAYING, WAIT_LISTEN, LISTEN_DELAY,
               LISTENING, ENDING, FINISHED } call_state_t;
typedef struct {
    voice_transport_t server, m5;
    uint32_t session, turn, input_count, output_count, output_ack, listen_generation;
    uint32_t next_turn, input_report_count;
    bool output_ended, end_after_playback, may_have_answered;
    const char *io_failure;
    call_state_t state;
    TickType_t began, phase, last_m5, last_server, last_ping, playback_done;
} call_t;
static call_t call;
static volatile bool busy, start_requested, stop_requested, recovery_required;
static volatile uint8_t probe_requested;
/* Recovery bookkeeping; only the voice task touches it after run_call() sets it up. */
static TickType_t recovery_began, recovery_logged;
static uint32_t recovery_delay_ms, recovery_attempts;
static bool recovery_log_seen;
/* v2 keeps the agent idle until call_started, so the API can be proven reachable
 * before the servo answers the intercom. Legacy v1 greets on ready: old order. */
#define VOICE_SERVER_FIRST (VOICE_RELAY_PROTOCOL!=1)

bool voice_stream_busy(void) { return busy; }
void voice_stream_request_call(void) {
    if (!recovery_required) start_requested=true;
    else printf("[VOICE] M5 state unconfirmed; new calls wait for automatic recovery.\n");
}
void voice_stream_request_stop(void) { stop_requested=true; }
void voice_stream_request_probe(void) { probe_requested=true; }
void voice_stream_request_api_probe(void) { probe_requested=2; }
static bool control(voice_transport_t *l, uint8_t type, uint32_t turn, uint32_t sequence)
{
    voice_header_t h={.type=type,.session=call.session,.turn=turn,.sequence=sequence};
    return voice_transport_send(l,&h,NULL);
}
static void phase(call_state_t state)
{ call.state=state; call.phase=xTaskGetTickCount(); }
static bool relay(voice_transport_t *l, const voice_packet_t *p)
{
    bool ok=voice_transport_send(l,&p->header,p->payload);
    if (!ok) call.io_failure=l==&call.m5?"m5_send_failed":"server_send_failed";
    return ok;
}
static bool packet_session(const voice_packet_t *p)
{ return p->header.session==call.session; }

static bool server_packet(const voice_packet_t *p)
{
    const voice_header_t *h=&p->header;
    if (!packet_session(p)) return false;
    call.last_server=xTaskGetTickCount();
    if (h->type==VOICE_PING) return control(&call.server,VOICE_PONG,h->turn,h->sequence);
    if (h->type==VOICE_PONG) return true;
    if (h->type==VOICE_ERROR) {
        printf("[VOICE] Server rejected the session (see server log).\n"); return false;
    }
    if (h->type==VOICE_LISTEN) {
        if (call.state!=WAIT_LISTEN || call.end_after_playback || call.turn==UINT32_MAX || h->turn!=call.turn+1u) return false;
        call.next_turn=h->turn; phase(LISTEN_DELAY); return true;
    }
    if (h->turn!=call.turn) return false;
    switch (h->type) {
    case VOICE_OUTPUT_START:
        if (call.state!=WAIT_REPLY && !(voice_transport_legacy(&call.server) && call.state==LISTENING)) return false;
        if (voice_transport_legacy(&call.server)) {
            // LiveKit's VAD may respond before the endpoint's longer silence
            // boundary. Stop publishing input as soon as output arrives.
            e84_shared()->voice_record_enabled=0; e84_shared_release();
        }
        call.output_count=call.output_ack=0;
        call.output_ended=call.end_after_playback=false;
        if (!relay(&call.m5,p)) return false;
        phase(PLAYING); printf("[VOICE] Response %lu: recording paused, playing on M5.\n",(unsigned long)call.turn);
        return true;
    case VOICE_OUTPUT_AUDIO:
        if (call.state!=PLAYING || call.output_ended || h->sequence!=call.output_count || call.output_count>=3000) return false;
        if (!relay(&call.m5,p)) return false;
        ++call.output_count; return true;
    case VOICE_OUTPUT_END:
        if (call.state!=PLAYING || call.output_ended || !call.output_count || h->sequence!=call.output_count) return false;
        call.output_ended=true; call.end_after_playback=(h->flags&1)!=0;
        printf("[VOICE] Output ended: %lu frames; waiting for M5 playback completion.\n",(unsigned long)call.output_count);
        return relay(&call.m5,p);
    case VOICE_NO_REPLY:
        if (call.state!=WAIT_REPLY) return false;
        printf("[VOICE] No speech recognized for turn %lu; listening again.\n",(unsigned long)call.turn);
        phase(WAIT_LISTEN); return true;
    case VOICE_CALL_END:
        if (call.state!=WAIT_LISTEN && call.state!=WAIT_REPLY) return false;
        if (!relay(&call.m5,p)) return false;
        phase(ENDING); return true;
    default: return false;
    }
}
static bool m5_packet(const voice_packet_t *p)
{
    const voice_header_t *h=&p->header;
    if (!packet_session(p)) return false;
    call.last_m5=xTaskGetTickCount();
    if (h->type==VOICE_PING) return control(&call.m5,VOICE_PONG,h->turn,h->sequence);
    if (h->type==VOICE_PONG) return true;
    if (h->type==VOICE_ERROR) {
        printf("[VOICE] M5 rejected the operation; check its display and servo configuration.\n"); return false;
    }
    if (h->turn!=call.turn) return false;
    switch (h->type) {
    case VOICE_CALL_STARTED:
        if (call.state!=STARTING || h->turn) return false;
        phase(CONNECT_AGENT);
        printf("[VOICE] Call button operation complete; now connecting voice agent.\n"); return true;
    case VOICE_AUDIO_ACK:
        if (call.state!=PLAYING || h->sequence<=call.output_ack || h->sequence>call.output_count) return false;
        uint32_t previous_ack=call.output_ack;
        call.output_ack=h->sequence;
        if (call.output_ack/50u != previous_ack/50u)
            printf("[VOICE] Relay progress: sent=%lu ms acknowledged=%lu ms elapsed=%lu ms.\n",
                (unsigned long)(call.output_count*20u), (unsigned long)(call.output_ack*20u),
                (unsigned long)((xTaskGetTickCount()-call.phase)*1000u/pdMS_TO_TICKS(1000)));
        return relay(&call.server,p);
    case VOICE_PLAYBACK_DONE:
        if (call.state!=PLAYING || !call.output_ended || h->sequence!=call.output_count ||
            call.output_ack!=call.output_count) return false;
        call.playback_done=xTaskGetTickCount();
        if (!relay(&call.server,p)) return false;
        printf("[VOICE] M5 playback complete: turn %lu.\n",(unsigned long)call.turn);
        phase(WAIT_LISTEN); return true;
    case VOICE_CALL_ENDED:
        if (call.state!=ENDING) return false;
        /* A server disconnect after receiving its final ACK is harmless. */
        (void)relay(&call.server,p); call.may_have_answered=false; phase(FINISHED); return true;
    default: return false;
    }
}
static bool await_ready(voice_transport_t *l)
{
    TickType_t start=xTaskGetTickCount();
    voice_packet_t p;
    while (!stop_requested && xTaskGetTickCount()-start<pdMS_TO_TICKS(l->websocket?60000:10000)) {
        int r=voice_transport_poll(l,&p);
        if (r<0) return false;
        if (r>0) {
            if (!packet_session(&p)) return false;
            if (p.header.type==VOICE_READY) return p.header.turn==0;
            if (p.header.type!=VOICE_PING || !control(l,VOICE_PONG,p.header.turn,p.header.sequence)) return false;
        }
        vTaskDelay(pdMS_TO_TICKS(1));
    }
    return false;
}
static bool check_m5_alive(void)
{
    if (!control(&call.m5,VOICE_PING,0,1)) return false;
    TickType_t start=xTaskGetTickCount();
    voice_packet_t p;
    while (!stop_requested && xTaskGetTickCount()-start<pdMS_TO_TICKS(5000)) {
        int r=voice_transport_poll(&call.m5,&p);
        if (r<0) return false;
        if (r>0) return packet_session(&p) && p.header.type==VOICE_PONG &&
            p.header.turn==0 && p.header.sequence==1;
        vTaskDelay(pdMS_TO_TICKS(1));
    }
    return false;
}
static bool run_m5_probe(uint32_t session)
{
    memset(&call,0,sizeof(call)); call.session=session;
    voice_transport_init(&call.server); voice_transport_init(&call.m5);
    bool ok=false;
    const char *reason="connect_failed";
    printf("[M5 TCP] Checking voice connection; no buttons, microphone or agent started.\n");
    if (!voice_transport_m5(&call.m5)) goto done;
    reason="not_accepted";
    voice_header_t hello={.type=VOICE_HELLO,.session=session,.length=strlen(M5_TOKEN)};
    if (!voice_transport_send(&call.m5,&hello,M5_TOKEN) || !await_ready(&call.m5)) goto done;
    reason="pong_missing";
    if (!check_m5_alive()) goto done;
    ok=true;
done:
    printf("[M5 TCP] %s\n",ok?"OK: authenticated HELLO/READY and PING/PONG; no buttons operated.":reason);
    voice_transport_close(&call.m5); voice_transport_close(&call.server);
    return ok;
}
static bool run_api_probe(uint32_t session)
{
    memset(&call,0,sizeof(call)); call.session=session;
    voice_transport_init(&call.server); voice_transport_init(&call.m5);
    call.server.diagnostic=true;
    bool ok=false, ready=false;
    const char *reason="connect_failed";
    printf("[API WSS] checking; no call_started, microphone or buttons.\n");
    if (!voice_transport_server(&call.server)) goto done;
    reason="ready_failed";
    if (!control(&call.server,VOICE_HELLO,0,0) || !await_ready(&call.server)) goto done;
    ready=true;
    reason="pong_missing";
    if (!control(&call.server,VOICE_PING,0,1)) goto done;
    TickType_t start=xTaskGetTickCount();
    voice_packet_t p;
    while (!stop_requested && xTaskGetTickCount()-start<pdMS_TO_TICKS(5000)) {
        int r=voice_transport_poll(&call.server,&p);
        if (r<0) break;
        if (r>0) {
            ok=packet_session(&p) && p.header.type==VOICE_PONG && p.header.turn==0 && p.header.sequence==1;
            break;
        }
        vTaskDelay(pdMS_TO_TICKS(1));
    }
done:
    if (ready) (void)control(&call.server,VOICE_CANCEL,0,0);
    printf("[API WSS] %s\n",ok?"OK: TLS, API authorization, relay READY and PING/PONG; no conversation started.":reason);
    voice_transport_close(&call.server); voice_transport_close(&call.m5);
    return ok;
}
static bool await_call_started(void)
{
    /* M5 allows up to 30 s before its single press, 2 s holding and 3 s
     * returning. No agent session exists until it acknowledges release. */
    TickType_t start=xTaskGetTickCount(), last_ping=start;
    while (!stop_requested && e84_network_voice_ready() &&
           xTaskGetTickCount()-start<pdMS_TO_TICKS(65000)) {
        voice_packet_t p;
        int r;
        if (VOICE_SERVER_FIRST) {
            /* The API session already exists: keep it alive and notice its loss. */
            r=voice_transport_poll(&call.server,&p);
            if (r<0) { call.io_failure="server_connection_lost"; return false; }
            if (r>0 && !server_packet(&p)) { call.io_failure="server_protocol_error"; return false; }
        }
        r=voice_transport_poll(&call.m5,&p);
        if (r<0 || (r>0 && !m5_packet(&p))) return false;
        if (call.state==CONNECT_AGENT) return true;
        if (xTaskGetTickCount()-last_ping>=pdMS_TO_TICKS(5000)) {
            if (!control(&call.m5,VOICE_PING,0,0)) return false;
            if (VOICE_SERVER_FIRST && !control(&call.server,VOICE_PING,0,0)) {
                call.io_failure="server_send_failed"; return false;
            }
            last_ping=xTaskGetTickCount();
        }
        vTaskDelay(pdMS_TO_TICKS(1));
    }
    return false;
}
static bool pause_capture(bool active)
{
    volatile e84_shared_t *s=e84_shared();
    s->voice_call_active=active?1u:0u; e84_shared_release();
    TickType_t start=xTaskGetTickCount();
    while (xTaskGetTickCount()-start<pdMS_TO_TICKS(2000)) {
        e84_shared_acquire();
        if (s->voice_call_ack==(active?1u:0u)) {
            e84_shared_acquire();
            s->voice_read_seq=s->voice_write_seq; e84_shared_release(); return true;
        }
        vTaskDelay(pdMS_TO_TICKS(5));
    }
    return false;
}
static bool begin_listen(void)
{
    volatile e84_shared_t *s=e84_shared();
    e84_shared_acquire();
    if (voice_transport_legacy(&call.server)) {
        // Any frames still being published when LiveKit began its response
        // belong to the previous turn, not to the next microphone window.
        s->voice_read_seq=s->voice_write_seq; e84_shared_release();
    }
    if (!s->voice_call_ack || s->voice_listen_seq==UINT32_MAX ||
        s->voice_write_seq!=s->voice_read_seq) return false;
    call.turn=call.next_turn; call.input_count=call.input_report_count=0;
    if (!control(&call.server,VOICE_INPUT_START,call.turn,0)) return false;
    s->voice_listen_turn=call.turn;
    s->voice_rms_gate=VOICE_RMS_GATE;
    s->voice_record_enabled=1;
    e84_shared_release(); call.listen_generation=++s->voice_listen_seq; e84_shared_release();
    phase(LISTENING);
    printf("[VOICE] Listening: turn %lu; max 30s / silence 1.2s.\n",(unsigned long)call.turn);
    return true;
}
static bool capture_step(void)
{
    volatile e84_shared_t *s=e84_shared();
    e84_shared_acquire();
    if (s->audio_status!=1) return false;
    if (s->voice_listen_ack!=call.listen_generation)
        return xTaskGetTickCount()-call.phase<pdMS_TO_TICKS(2000);
    uint32_t end_generation=s->voice_end_listen_seq;
    e84_shared_acquire();
    if (end_generation==call.listen_generation && s->voice_end_reason>=3) {
        const char *reason=s->voice_end_reason==3?"send buffer overflow":
            s->voice_end_reason==4?"microphone capture gap":"cancelled";
        printf("[VOICE] Capture aborted: %s (reason %lu); sent=%lu ms queued=%lu frames; incomplete turn discarded.\n",
            reason,(unsigned long)s->voice_end_reason,(unsigned long)(call.input_count*20u),
            (unsigned long)(s->voice_write_seq-s->voice_read_seq));
        return false;
    }
    /* Bounded catch-up pass: still service both network peers every iteration. */
    for (unsigned i=0;i<4;++i) {
        uint32_t write=s->voice_write_seq;
        e84_shared_acquire();
        uint32_t read=s->voice_read_seq;
        if (write==read) break;
        if (write-read>E84_VOICE_RING_FRAMES || call.input_count>=1500) return false;
        uint8_t pcm[640];
        for (unsigned n=0;n<320;++n) {
            uint16_t sample=(uint16_t)s->voice_pcm[read%E84_VOICE_RING_FRAMES][n];
            pcm[n*2]=(uint8_t)sample; pcm[n*2+1]=(uint8_t)(sample>>8);
        }
        voice_header_t h={.type=VOICE_INPUT_AUDIO,.session=call.session,.turn=call.turn,
            .sequence=call.input_count,.length=sizeof(pcm)};
        if (!voice_transport_send(&call.server,&h,pcm)) {
            printf("[VOICE] Microphone frame send failed: frame=%lu queued=%lu.\n",
                (unsigned long)call.input_count,(unsigned long)(s->voice_write_seq-s->voice_read_seq));
            return false;
        }
        if (!call.input_count) call.phase=xTaskGetTickCount();
        ++call.input_count;
        e84_shared_release(); s->voice_read_seq=read+1u; e84_shared_release();
        if (call.input_count==1u || call.input_count-call.input_report_count>=50u) {
            call.input_report_count=call.input_count;
            printf("[VOICE] Input streaming: sent=%lu ms queued=%lu frames rms=%lu.\n",
                (unsigned long)(call.input_count*20u),
                (unsigned long)(s->voice_write_seq-s->voice_read_seq),
                (unsigned long)s->last_rms);
        }
    }
    e84_shared_acquire();
    if (s->voice_end_listen_seq==call.listen_generation) {
        e84_shared_acquire();
        if (s->voice_end_reason!=1 && s->voice_end_reason!=2) return false;
        if (s->voice_read_seq==s->voice_end_seq) {
            if (!call.input_count || s->voice_end_turn!=call.turn || s->voice_samples!=call.input_count*320) return false;
            voice_header_t h={.type=VOICE_INPUT_END,.flags=s->voice_end_reason==2?1:0,
                .session=call.session,.turn=call.turn,.sequence=call.input_count};
            if (!voice_transport_send(&call.server,&h,NULL)) return false;
            s->voice_record_enabled=0; e84_shared_release();
            phase(WAIT_REPLY);
            printf("[VOICE] Input complete: %lu ms; recording paused.\n",(unsigned long)(call.input_count*20));
        }
    }
    return true;
}
static bool end_on_error(void)
{
    (void)control(&call.server,VOICE_CANCEL,call.turn,0);
    bool submitted=control(&call.m5,VOICE_CANCEL,call.turn,0);
    if (!call.may_have_answered) return true;
    if (!submitted) return false;
    TickType_t start=xTaskGetTickCount();
    voice_packet_t p;
    while (xTaskGetTickCount()-start<pdMS_TO_TICKS(65000)) {
        int r=voice_transport_poll(&call.m5,&p);
        if (r<0) break;
        if (r>0 && packet_session(&p)) {
            if (p.header.type==VOICE_CALL_ENDED && p.header.turn==call.turn) return true;
            if (p.header.type==VOICE_ERROR) return false;
        }
        vTaskDelay(pdMS_TO_TICKS(5));
    }
    return false;
}
static bool connect_server(const char **reason)
{
    *reason="server_connect_failed";
    if (!voice_transport_server(&call.server)) return false;
    *reason="server_ready_failed";
    if (!control(&call.server,VOICE_HELLO,0,0) || !await_ready(&call.server)) return false;
    printf("[VOICE] Server ready: /api/relay protocol %u.\n",voice_transport_legacy(&call.server)?1u:2u);
    return true;
}
static void enter_recovery(void)
{
    recovery_began=xTaskGetTickCount(); recovery_delay_ms=VOICE_RECOVERY_RETRY_MIN_MS;
    recovery_attempts=0; recovery_log_seen=false;
    recovery_required=true;
}
static bool run_call(uint32_t session)
{
    memset(&call,0,sizeof(call)); call.session=session; voice_transport_init(&call.server); voice_transport_init(&call.m5);
    bool success=false, release=false;
    const char *reason="capture_pause_failed";
    printf("[VOICE] Preparing streaming call.\n");
    if (!pause_capture(true)) goto cleanup;
    if (VOICE_SERVER_FIRST) {
        /* The servo answers the real intercom: prove the API is usable first.
         * On failure nothing has been pressed and chime detection is re-armed. */
        if (!connect_server(&reason)) {
            if (!stop_requested) printf("[VOICE] API unreachable (%s); intercom button not pressed.\n",reason);
            goto cleanup;
        }
    }
    /* Complete the physical button operation before starting an agent. */
    reason="m5_connect_failed";
    if (!voice_transport_m5(&call.m5)) goto cleanup;
    voice_header_t hello={.type=VOICE_HELLO,.session=session,.length=strlen(M5_TOKEN)};
    reason="m5_auth_failed";
    if (!voice_transport_send(&call.m5,&hello,M5_TOKEN) || !await_ready(&call.m5)) goto cleanup;
    reason="m5_probe_failed";
    if (!check_m5_alive() || stop_requested) goto cleanup;
    phase(STARTING); call.began=call.last_server=call.last_m5=call.last_ping=xTaskGetTickCount();
    call.may_have_answered=true;
    reason="call_button_failed";
    if (!control(&call.m5,VOICE_CALL_START,0,0)) goto cleanup;
    printf("[VOICE] Waiting for one call-button press and release; voice agent not started.\n");
    if (!await_call_started() || stop_requested) {
        if (call.io_failure) reason=call.io_failure;
        goto cleanup;
    }
    if (!VOICE_SERVER_FIRST && !connect_server(&reason)) goto cleanup;
    reason="agent_start_failed";
    if (stop_requested || !control(&call.server,VOICE_CALL_START,0,0)) goto cleanup;
    phase(WAIT_REPLY);
    call.last_server=call.last_m5=call.last_ping=xTaskGetTickCount();
    while (!stop_requested && e84_network_voice_ready()) {
        voice_packet_t p;
        int r=voice_transport_poll(&call.m5,&p);
        if (r<0) { reason="m5_connection_lost"; break; }
        if (r>0 && !m5_packet(&p)) { reason=call.io_failure?call.io_failure:"m5_protocol_error"; break; }
        if (call.state==FINISHED) { reason="completed"; success=true; break; }
        bool server_failed=false;
        // Drain a bounded burst, then return to M5 acknowledgements and capture.
        for (unsigned packet=0;packet<4;++packet) {
            r=voice_transport_poll(&call.server,&p);
            if (r<0) { reason="server_connection_lost"; server_failed=true; break; }
            if (!r) break;
            if (!server_packet(&p)) { reason=call.io_failure?call.io_failure:"server_protocol_error"; server_failed=true; break; }
        }
        if (server_failed) break;
        TickType_t now=xTaskGetTickCount();
        if (call.state==LISTEN_DELAY && now-call.playback_done>=pdMS_TO_TICKS(VOICE_SETTLE_MS))
            if (!begin_listen()) { reason="microphone_start_failed"; break; }
        if (call.state==LISTENING && !capture_step()) { reason="microphone_or_send_failed"; break; }
        now=xTaskGetTickCount();
        if (now-call.began>pdMS_TO_TICKS(VOICE_CALL_TIMEOUT_MS)) { reason="device_time_limit"; break; }
        if (now-call.phase>pdMS_TO_TICKS(call.state==LISTENING?VOICE_IDLE_TIMEOUT_MS:VOICE_RESPONSE_TIMEOUT_MS)) {
            reason=call.state==LISTENING?"speech_wait_timeout":"response_timeout"; break;
        }
        if (now-call.last_m5>pdMS_TO_TICKS(15000)) { reason="m5_keepalive_timeout"; break; }
        if (!voice_transport_legacy(&call.server) && now-call.last_server>pdMS_TO_TICKS(15000)) {
            reason="server_keepalive_timeout"; break;
        }
        if (now-call.last_ping>=pdMS_TO_TICKS(5000)) {
            if (!control(&call.m5,VOICE_PING,call.turn,0) || !control(&call.server,VOICE_PING,call.turn,0)) { reason="keepalive_send_failed"; break; }
            call.last_ping=now;
        }
        vTaskDelay(pdMS_TO_TICKS(1));
    }
cleanup:
    if (stop_requested) reason="manual_stop";
    else if (!e84_network_voice_ready()) reason="network_lost";
    printf("[VOICE] Call ending: reason=%s state=%u turn=%lu input_ms=%lu.\n",
        reason,(unsigned)call.state,(unsigned long)call.turn,(unsigned long)(call.input_count*20u));
    e84_shared()->voice_record_enabled=0; e84_shared_release();
    release=success || end_on_error();
    voice_transport_close(&call.server); voice_transport_close(&call.m5);
    if (release && pause_capture(false)) {
        printf("[VOICE] %s; chime detection rearmed.\n",success?"Call ended":"Call stopped");
        return true;
    }
    /* Cannot prove that M5 stopped: hold capture muted until recovery_step()
     * reconnects and the M5 confirms it is idle. */
    enter_recovery();
    busy=false; // Closed transports are free for diagnostics; new calls remain inhibited.
    printf("[VOICE] Playback/call state uncertain. Recording remains paused; reconnecting to the M5 automatically (first retry in %lu s). Diagnostics available.\n",
        (unsigned long)(recovery_delay_ms/1000u));
    return false;
}
/* Fresh session, CANCEL only: the M5 answers CALL_ENDED without actuating a servo
 * (no call exists in this session) and refuses HELLO while a servo is moving. It
 * never sends CALL_START/CALL_END, so recovery can neither call nor press. */
static bool run_recovery(uint32_t session, const char **reason)
{
    memset(&call,0,sizeof(call)); call.session=session;
    voice_transport_init(&call.server); voice_transport_init(&call.m5);
    bool ok=false;
    *reason="m5_connect_failed";
    if (!voice_transport_m5(&call.m5)) goto done;
    voice_header_t hello={.type=VOICE_HELLO,.session=session,.length=strlen(M5_TOKEN)};
    *reason="m5_auth_failed";
    if (!voice_transport_send(&call.m5,&hello,M5_TOKEN) || !await_ready(&call.m5)) goto done;
    *reason="cancel_send_failed";
    if (!control(&call.m5,VOICE_CANCEL,0,0)) goto done;
    *reason="end_unconfirmed";
    TickType_t start=xTaskGetTickCount();
    while (!stop_requested && xTaskGetTickCount()-start<pdMS_TO_TICKS(VOICE_RECOVERY_CONFIRM_MS)) {
        voice_packet_t p;
        int r=voice_transport_poll(&call.m5,&p);
        if (r<0) break;
        if (r>0 && packet_session(&p)) {
            if (p.header.type==VOICE_CALL_ENDED && p.header.turn==0) { ok=true; break; }
            if (p.header.type==VOICE_ERROR) break;
        }
        vTaskDelay(pdMS_TO_TICKS(5));
    }
    if (stop_requested) *reason="manual_stop";
done:
    voice_transport_close(&call.m5);
    if (ok) {
        *reason="capture_rearm_failed";
        ok=pause_capture(false);
    }
    return ok;
}
static bool next_session(volatile e84_shared_t *s, uint32_t *counter, uint32_t *session)
{
    if (*counter==UINT32_MAX) return false;
    *session=s->seed[0]^(++*counter);
    if (!*session) {
        if (*counter==UINT32_MAX) return false;
        *session=s->seed[0]^(++*counter);
    }
    return true;
}
/* Called by the voice task only when idle. Never overlaps a call or diagnostic. */
static void recovery_step(volatile e84_shared_t *s, uint32_t *counter)
{
    if (!recovery_required || busy) return;
    TickType_t now=xTaskGetTickCount();
    if (now-recovery_began<pdMS_TO_TICKS(recovery_delay_ms)) return;
    if (!VOICE_STREAM_ENABLED || !e84_network_voice_ready() || !m5_link_configured() || !s->seed_ready) return;
    uint32_t session;
    if (!next_session(s,counter,&session)) return; // ID space exhausted: stays muted
    stop_requested=false; busy=true;
    ++recovery_attempts;
    const char *reason="";
    bool cleared=run_recovery(session,&reason);
    busy=false;
    now=xTaskGetTickCount();
    if (cleared) {
        recovery_required=false;
        printf("[VOICE] M5 confirmed idle after %lu recovery attempt(s); chime detection rearmed.\n",
            (unsigned long)recovery_attempts);
        return;
    }
    recovery_began=now;
    if (recovery_delay_ms<VOICE_RECOVERY_RETRY_MAX_MS) {
        recovery_delay_ms*=2u;
        if (recovery_delay_ms>VOICE_RECOVERY_RETRY_MAX_MS) recovery_delay_ms=VOICE_RECOVERY_RETRY_MAX_MS;
    }
    if (!recovery_log_seen || now-recovery_logged>=pdMS_TO_TICKS(VOICE_RECOVERY_LOG_MS)) {
        recovery_log_seen=true; recovery_logged=now;
        printf("[VOICE] M5 state still uncertain (attempt %lu: %s). Recording remains paused; retry in %lu s.\n",
            (unsigned long)recovery_attempts,reason,(unsigned long)(recovery_delay_ms/1000u));
    }
}
void voice_stream_task(void *argument)
{
    (void)argument;
    uint32_t observed=0, counter=0;
    bool available_before=false;
    for (;;) {
        volatile e84_shared_t *s=e84_shared();
        bool available=VOICE_STREAM_ENABLED && e84_network_voice_ready() && m5_link_configured() && s->seed_ready;
        uint32_t guard=s->event_guard; e84_shared_acquire();
        uint32_t event=s->event_seq; e84_shared_acquire();
        bool detected=false;
        if (!(guard&1) && guard==s->event_guard && event!=observed) {
            observed=event; detected=event && available && available_before;
        }
        if (recovery_required) detected=false;
        bool manual=!recovery_required && start_requested; start_requested=false;
        uint8_t diagnostic=probe_requested; probe_requested=0;
        if ((detected || manual || diagnostic) && !busy) {
            bool ready=available;
            if (diagnostic==2 && !detected && !manual)
                ready=VOICE_STREAM_ENABLED && e84_network_voice_ready() && s->seed_ready;
            if (!ready) {
                if (diagnostic==2) printf("[API WSS] network_not_ready\n");
                else printf("[VOICE] Wi-Fi, clock, API or M5 configuration not ready.\n");
            }
            else if (counter==UINT32_MAX) printf("[VOICE] Session ID limit reached; reset required.\n");
            else {
                uint32_t session;
                if (!next_session(s,&counter,&session)) { available_before=available; vTaskDelay(pdMS_TO_TICKS(50)); continue; }
                stop_requested=false; busy=true;
                if (diagnostic && !detected && !manual) {
                    if (diagnostic==2) (void)run_api_probe(session);
                    else (void)run_m5_probe(session);
                    busy=false;
                }
                else {
                    if (run_call(session)) busy=false;
                    observed=s->event_seq; available_before=false;
                }
            }
        }
        else if (recovery_required) recovery_step(s,&counter);
        available_before=available;
        vTaskDelay(pdMS_TO_TICKS(50));
    }
}
