jphacks/tka_2601/PSOC_Edge_E84/source/wifi_settings.h

#pragma once
#include <stdbool.h>
#include "cy_wcm.h"

extern const char wifi_ssid[];
extern const char wifi_password[];
extern const bool wifi_hotspot_compatibility;
extern const cy_wcm_security_t wifi_security;
