jphacks/tka_2601/(commit log)

2026-10-17 Add intercom AI device spec and Hack Day work plan
    docs/spec.md: requirements, hardware, button-press mechanism, state
    machine, board protocol, door API integration, chime-detection ML,
    safety, tests, BOM and sources.
    docs/plan.md: roles for 3-5 people, two-day timeline, milestones,
    risks and demo script.
2026-10-17 Revise spec and plan for owned parts, USB speaker and HS-5496MH
    - Use the deployed door API (Kotoba-Whisper -> Gemma 4 -> Irodori-TTS)
    for the conversation; drop the on-Pi ASR/LLM and the M5 devices.
    - Build from parts on hand: laptop as the audio bridge, PSoC 6 PDM mic
    for both chime and visitor audio, two Hitec HS-5496MH servos for the
    talk/end buttons on a 6 V supply.
    - Buy only a USB speaker (Sanwa MM-SPU21BK or ELECOM MS-P08USB3BK),
    the servo power supply and tip/bracket materials.
    - Remove the USB mic and light sensor; guard against pressing an idle
    intercom with timing limits instead.
2026-10-17 Update spec to v0.5 for VS-SGE20LA intercom and MG996R servos
    - Target the Panasonic VS-SGE20LA (monitor VS-MGE20): ~20 s ring,
    ~1 min max call, separate talk/end buttons, mic at top-right and
    speaker at bottom-left; retime press deadline (15 s), normal-mode
    wait (8 s) and call cap (50 s) accordingly.
    - Note the push-to-talk switch on a ~2 s hold (cap holds at 500 ms)
    and offer push-to-talk as a fallback for voice-switch dropouts.
    - Switch servos to two Tower Pro MG996R powered from the C3 5V pin,
    with one-at-a-time moves and a bulk capacitor; drop HS-5496MH.
    - Add an Akizuki speaker option (USB amp module + 40 mm speaker).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
2026-10-17 Add conversation history and phone app requirements on Supabase
    - docs/history.md: requirements for storing each visit and its
    transcript in Supabase and showing them in a phone app (PWA):
    architecture (door API is the only writer, app reads via RLS),
    functional/non-functional requirements, data model, grants and RLS
    policies, Realtime, door API endpoints, bridge changes, retention via
    Supabase Cron, tests and open items.
    - spec.md v0.6: add FR-9, move mode switching to the app with the
    bridge web page as fallback, note stored transcripts in privacy.
    - plan.md: give P5 the app and Supabase, P4 the door API persistence;
    add prep items, timeline tasks, milestones and risks.
    Co-A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
2026-10-17 Rework history requirements around team decisions
    - history.md: separate the team's decisions (device writes to Supabase,
    door API unchanged, store text and outcomes only, app features are
    history, push notifications and mode switching, Flutter or React
    Native) from proposals and open items; drop the door API endpoints,
    PWA, realtime view, in-call decision, auto-deletion and family
    sharing that were never decided.
    - spec.md: FR-9 now says the device writes; add a bridge history
    module; remove the door API persistence request; mark retention as
    undecided; keep ntfy only until app push works.
    - plan.md: move Supabase writes to P3, keep P4 on conversation quality,
    give P5 the na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
2026-10-17 Add doorbell audio enrollment and recording prototype
2026-10-17 Add Supabase backend for visit history and push notifications
    - Migrations for households, household_members, devices, visits,
    visit_messages and push_tokens with RLS, explicit grants (no anon),
    membership helpers in a private schema, and Realtime on devices
    - Residents read their household, change device mode and delete visits
    one at a time; the device account writes its own device's visits and
    messages; last_seen_at is updated by trigger
    - Database Webhook via pg_net + Vault that calls the push Edge Function,
    which sends Expo notifications to the household's push tokens
    - Local seed script, pgTAP tests (H1-H4, H3b) and an end-to-end test
    through Auth, Data API, Realtime, webhoo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
2026-10-17 Switch device writes to an Edge Function with device keys
    The device is now the PSoC 6 alone, which does not sign in to Supabase.
    It calls the new device Edge Function with a fixed device key; the
    function checks the key's SHA-256 against device_keys and writes with
    the secret key through device_authenticate and device_put_visit.
    - Drop devices.auth_user_id, the device-account RLS policies and the
    Realtime publication; residents' permissions are unchanged
    - device_keys has RLS and no grants for any role
    - device_put_visit handles create, status updates and the post-call
    batch of messages and results in one transaction, inserts messages
    before changing the status, and never moves the s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
2026-10-17 Document the device API and key registration in the Supabase README
2026-10-17 Rewrite spec for the PC-less PSoC 6 design (v0.7)
    - Remove the laptop bridge and everything that depended on it (USB
    serial, PC speaker and mic, bridge web page, ntfy).
    - PSoC 6 (CY8CPROTO-062-4343W) talks to the conversation server over a
    WebSocket relay on FastAPI that joins the LiveKit room, writes to
    Supabase via an Edge Function with a device key (transcripts batched
    after the call), drives two SG90s by PWM with external 5 V, and plays
    audio through an I2S amplifier.
    - Use the implemented DTW chime enrollment; drop radar presence.
    - Update history.md (PSoC writer, device keys) and plan.md (roles,
    timeline, risks, demo, new repository layout).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
2026-10-17 Add groups, invites, member profiles, settings and device pairing
    Requested by the resident app (decided by the user on 2026-10-17):
    - visits.intent accepts acquaintance; the push title shows 知人
    - Residents create a group, share an invite token (no expiry, reusable)
    and join with it; household_members.user_id is unique so a person
    belongs to one group
    - household_member_profiles returns names (full_name, else name) and
    emails of the caller's group
    - devices gets away_leave_at_door, auto_away and extra_instructions
    (residents may update) and auto_away_active (written by the device)
    - Devices are registered by an admin with private.register_device and
    bound to a group when a res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
2026-10-17 Serialize concurrent writes to the same visit
    Review on PR #4: SELECT ... FOR UPDATE cannot lock a visit that does
    not exist yet, so two overlapping PUTs for a new visit both inserted
    and one failed with 23505 (a 500 from the device function). Take a
    transaction advisory lock on the visit id before the existence check.
    Reproduced with 6 concurrent PUTs x 10 visits (9 of 60 failed) and
    fixed (60 of 60 succeeded); the e2e test now covers it.
    Also revoke EXECUTE on the resident RPC wrappers from service_role so
    the cloud project, which still grants new public functions to
    service_role by default, matches local.
2026-10-17 Retry push notifications and send them with high priority
    Review on PR #4:
    - A transient Expo failure (network error, 429, 5xx) ended the only
    delivery attempt. The push function now records each notification
    per token in push_deliveries before sending, retries transient
    failures in-process (1 s, 3 s), and leaves the rest pending. A
    pg_cron job checks every minute and asks the function to resend due
    deliveries. Tokens Expo accepted are never sent again, and pending
    deliveries are given up 10 minutes after the notice was created
    (decided by the user). MessageRateExceeded tickets are retried;
    DeviceNotRegistered and other errors are not.
    - Messages now set priority "high" for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
2026-10-17 Document groups, device pairing, settings and push retry in the README
2026-10-17 Note how the conversation relay reads household settings
2026-10-17 Track backend CI branch for automatic deployment
2026-10-17 Limit extra_instructions to 350 characters
    house_rules must stay within 800 characters, and in the longest base
    rules (away mode with leave-at-door) 350 characters remain for the
    residents' extra instructions, per the conversation relay. Decided by
    the user on 2026-10-17. Covered by pgTAP and the e2e test.
2026-10-17 Link the EAS project and cap extra instructions at 350 characters
    The EAS project ID goes to extra.eas.projectId so push tokens can be
    requested. The 350-character cap matches the devices check constraint
    added in PR #4.
2026-10-17 Add the PSoC 6 WebSocket relay and per-house rules
    /api/relay joins a LiveKit room on behalf of the PSoC 6, streams its
    16 kHz PCM as a track, and returns the agent's voice, final transcripts
    and agent states. At the start of each conversation it reads the house
    settings once from the Supabase device Edge Function with the device
    key and builds house_rules from the mode, the away leave-at-door
    permission and the resident's extra instructions.
    Also adds tests with LiveKit and Supabase mocked, a PSoC simulator and
    stand-in model servers for checking without hardware or labpc, and
    updates spec 5.3, 5.4 and 5.6.
2026-10-17 Match the Supabase settings response and wait 1.5 s for it
    The device settings Edge Function (PR #4) returns paired, mode and
    auto_away as well; the relay keeps using only away_leave_at_door and
    extra_instructions, and the mode from the PSoC start message. The
    settings timeout default goes from 1 s to 1.5 s after measuring the
    cloud endpoint at 0.4-1.0 s.
2026-10-17 Add VS-MGE20 hardware model and print files
2026-10-17 Add EAS build profiles and the development client
    eas.json defines development (device and simulator), preview and
    production profiles, each tied to an EAS environment for the Supabase
    variables. expo-dev-client lets development builds load from Metro,
    and the export compliance flag is declared for App Store Connect.
2026-10-17 Ignore env files and app signing secrets repo-wide
    Ignore every .env and .env.* file (keeping the *.example templates),
    APNs/Android signing material (*.p8, *.p12, *.jks, *.keystore,
    *.mobileprovision) and EAS local credentials (credentials.json,
    credentials/) at the repository root, so Supabase and Expo secrets stay
    out of Git regardless of which directory they land in.
2026-10-17 Align docs with the Supabase, app and relay implementation (v0.8)
    - history.md: describe the implemented Supabase schema and values,
    device API (settings, visits, state), groups, invites, pairing,
    push retries, the Expo app in mobile/, and current open items.
    - spec.md: relay reads household settings once with the device key and
    builds house_rules (extra instructions, away leave-at-door, 800-char
    cap); use the real device endpoints and visit status/outcome values;
    flag auto_away and "resident" as needing presence detection.
    - plan.md: mark Supabase and the app as implemented, relay in
    progress, and rename app/ to mobile/ in the layout.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
2026-10-17 Note the 350-character limit on extra instructions
    Supabase (PR #4) now caps devices.extra_instructions at 350 characters;
    update history.md and spec.md 5.6, and refresh the test counts.
2026-10-17 Stabilize delivery follow-ups and interrupted speech
2026-10-17 Have the relay write the conversation text to Supabase (spec v0.9)
    The team decided that the relay, not the PSoC 6, writes the transcript.
    Describe who writes what through the device API, record how the relay's
    writer in main behaves today, and list the gaps it leaves in chapter 10
    (missing end reason and outcome, overwritten chime time, no resend).
    Also note that the app has no screen for the pairing code and that the
    app was checked against the cloud Supabase on the simulator.
2026-10-17 Add E84 and M5 voice calls through relay v2
    Use the existing /api/relay endpoint with device-controlled 30-second utterances and 1.2-second silence detection. Wait for confirmed M5 playback before starting the next recording, reuse DoorAgent and visit history, and retain the original relay protocol.
    Include the E84 and M5 firmware, custom BSP, configuration templates, host tests, and setup documentation. Keep private settings and generated firmware out of version control.
2026-10-18 Fix servo calibration and improve door voice conversations
    Add persistent Web UI calibration, timed single button presses, END-only direction mirroring and conversation logs. Gate voice-agent startup on the completed call-button operation, support the deployed relay protocol, improve delivery completion handling, and include the manual server update package.
2026-10-18 Add public Supabase key to device API calls
2026-10-18 Drop the operating mode from the chime notification (#16)
    The resident does not need "（通常モード）" in the alert. The chime
    notification now only says when the chime rang. Already deployed to the
    cloud project.
2026-10-18 Fix servo release, audio flow control and communication diagnostics
2026-11-02 feat(firmware): port E84 and M5 functions to XIAO ESP32S3
    One chip now does chime detection, WSS relay, playback and servo control.
    Host tests and an end-to-end test against the real relay code pass. Not yet
    run on hardware; README lists what remains unverified.
2026-11-02 feat: add shop reservations, notifications and natural language input
    Retarget the app at small shops such as nail salons, massage shops and
    cram schools, where the person using the phone runs the shop.
    Supabase:
    - Add a ReservationProvider port with MONBAN ledger, Google Calendar,
    Square and Hot Pepper implementations. Google and Square are read live
    instead of being copied; Hot Pepper has no public API, so it uses the
    ledger plus an approval list.
    - AI reservations always start as pending and the shop confirms them.
    - Add extensible notification kinds, per-kind preferences, an inbox and
    read state. Push deliveries now hang off the notification record.
    - Add the assistant function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
2026-11-02 feat(firmware): rebuild the XIAO bench page for checking and tuning
    Five approved screens replace the ported page: checklist, servo, audio, chime
    registration and test call. bash run.sh bench runs the page against the real
    firmware and relay code on the Mac. Not yet run on hardware.
2026-11-02 test(firmware): boot the real ESP32-S3 binary in QEMU
    bash run.sh qemu drives the serial console and checks persistence across a
    restart. It found that a dead microphone was reported as busy, now fixed, and
    that the mic failure was logged every second.
2026-11-02 fix: address PR review findings for reservations and notifications
    - Split partial connection updates from upserts; partial upserts always
    failed the NOT NULL check, which broke Google calendar selection and
    Square token refresh. The fake store now enforces the same rule, and
    e2e runs the real store against the real database.
    - Hold OAuth tokens until the app finishes the login with the user's JWT,
    so a consent URL made by another account cannot attach a shop's
    calendar to that account.
    - Stop returning phone numbers and notes to the device API, cap its range
    at 31 days, and reject datetimes without an offset.
    - Create the notification and its push queue atomically, let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
2026-11-02 ci(firmware): let the team run the XIAO checks anywhere
    Scripts no longer assume one Mac: they find arduino-cli, install the ESP32 core
    when missing, and pick the QEMU build per platform with a pinned SHA-256.
    GitHub Actions runs host tests, the relay test, the build and QEMU on PRs.
    bash run.sh qemu ui opens the bench page on the emulated board.
2026-11-02 feat: rework the reservations tab around pending cards
    Redesign the shop screens from Claude Design v2.
    - Put a plus button beside the title and switch list, day, week and
    month with the native segmented control. The list opens first.
    - Remove the approval band and screen. Pending reservations sit under
    the next reservation as framed cards with inline approve and decline.
    - Add SF Symbols to settings, visits and notifications, and use native
    alerts for confirmation.
    - Center switches in their rows; iOS defaults them to flex-start.
    - Add the expo-font peer dependency that expo-symbols requires.
    - Stop calling the approval flow a list in the docs and comments.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
2026-11-02 feat(firmware): rebuild the bench page with Ant Design and a live 3D model
    Every screen now shows the printed parts on the chosen intercom, moved by
    what the board logs, so servo presses, ringing and audio can be watched
    during normal work. The intercom and exterior are shared menus backed by
    one table each, and measured sizes and key positions can replace the
    published estimates. The fit check flags parts that hit a key or the stand.
    React and antd are vendored so the page still needs no build step. The new
    test screen runs the same commands as the terminal and CI, and the bench
    firmware can play a chime or another sound from the page.
    The default CALL press was 180 degrees, which would d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
2026-11-02 feat(firmware): add the surveyed intercoms to the bench model
    The table grows from 8 to 19 entries, about 36 model numbers. The new ones
    have published outlines but only a sentence on where the keys are, so they
    are marked rough and the page says their layout is provisional. Windea-R and
    Windea D need a vertical rail, which has no design yet.
2026-11-02 test(firmware): click through the bench page in a real browser
    Until now nothing rendered the page outside manual use, so a broken screen
    would have passed CI. `run.sh browser` opens the real page in Chromium against
    the real firmware code and goes through every screen, the model, chime
    registration and a whole call, failing on any console error.
    Its first runs found a real bug: a step button's delayed commit could arrive
    after undo or save and restart calibration, and calibration makes the firmware
    refuse calls, so the next chime silently ended in servo_busy. Late commits are
    now ignored, and the call screens say when calibration is pausing calls.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
2026-11-02 feat: add a one-command App Store review account
    Create the review account, its shop and a keyless device row, then load
    the demo data. The password is generated and shown once, and is never
    stored in the repository.
    Scope demo ids to each shop, since the fixed ids collided as soon as a
    second account was seeded.
2026-11-02 fix(firmware): correct review findings in the bench page, tests and call flow
    Bench page:
    - A servo edit the board refused was lost, and save then reported success with
    the old values. Refused edits now stay due, and a failed cancel keeps them.
    - Undo could race a begin or a delayed commit and leave calibration running,
    which pauses calls. A press also could not use an angle other than the one
    on screen, and the rack text no longer claims a key press from nominal angles.
    - A reset while USB is away left the page stuck in a call. The board now reports
    its call state and uptime on `s`, and the server asks until it answers.
    - The capsule numbers and meshes follow the current CAD, so the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
2026-11-02 fix(firmware): draw every servo press on slow machines
    The model's press animation was capped per frame, so at a few frames a second
    the rack started back before reaching the key: on the CI runner's software
    rendering it stopped at 1.18 mm of a 1.5 mm gap. Presses now follow real time
    and are drawn all the way in before returning. The browser test can throttle the
    page's CPU, to try this on a fast machine.
2026-11-02 feat: add a web version of the app for Vercel
    Run the Expo app on react-native-web and deploy it as a static single-page
    build. Native-only parts get .web.ts(x) counterparts: a sidebar/bottom-bar
    shell instead of NativeTabs, Material Symbols icons, browser confirm/alert,
    a segmented control, a date input, and clipboard copy for invites.
    Web has no push notifications. New notifications are polled every 30s and
    shown as an in-page toast instead.
2026-11-02 fix: recover from comms failures in relay, PSoC call flow and updater
    - relay(v1): wait up to 10 s for the agent to join the LiveKit room before
    sending ready, and end the call with agent_unavailable when the last agent
    participant leaves mid-call instead of idling until the time limit.
    - PSoC: connect to the API and wait for ready before the M5 presses the real
    intercom button (v2); an unreachable API no longer answers the intercom.
    - PSoC: retry M5 recovery automatically (HELLO + CANCEL only, 10-30 s backoff)
    instead of staying muted until both boards are reset.
    - auto-update.ps1: restart the services in place when the update fails after
    they were stopped but before the backup ex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
2026-11-03 chore(hardware): add the JLCPCB order files for the XIAO add-on board v1 (#26)
    BOM, CPL and the panel gerber zip that were sent to JLCPCB, moved in from
    Downloads. Same path as the board's other design files so they merge cleanly.
2026-11-03 fix: widen the relay v2 call-start deadline and refresh PR #25 docs
    CALL_START_SECONDS counted 65 s from `ready`, while the E84 waits 65 s from
    CALL_START after M5 connect, HELLO/READY and PING/PONG. The server could fire
    time_limit first and mask m5_* failures. Raise it to 100 s (device worst case
    is 90 s) and document the budget. Also update spec 5.4 for the agent-join wait
    and agent_unavailable meanings, and the M5 README for E84 auto-recovery.
2026-11-03 fix(xiao): connect to the API before pressing the call button and recover automatically from an unconfirmed call end
    PR #25 の通信復旧修正を XIAO ファームウェアへ移植。
    - v2 は API の ready を確認してからサーボで通話ボタンを押す。届かなければ押さない。v1 は従来順
    - ボタン動作中は 5 秒ごとの PING で API 接続を保ち、切断を検知する
    - 終了を確認できないときは、10/20/30 秒の間隔で自動復旧する。終了ボタンだけを押し、通話ボタンは押さない
    - ホストテスト(v2/v1)、e2e、calibration UI の文言を更新
2026-11-03 feat: connect the voice backend's reception API and move reservation sources into a 連携 section
    - Edge Function "door" relays the voice backend (OpenAPI v1.1.0) reception
    settings, visit history and Google Calendar link. The Bearer key stays on
    the server and only allow-listed households can use it.
    - The app gets a ReceptionRepository, reception and guidance screens, and a
    Google Calendar link for matching visits to reservations.
    - The single-choice 予約先 screen is replaced by a 連携 section (Google
    Calendar, Square, Hot Pepper Beauty). Each can be connected; one is used
    for the reservation list via a switch.
    - The reception screens are behind EXPO_PUBLIC_FEATURE_RECEPTIO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
2026-11-04 feat: configure shared and separate XIAO pushers from app
    Refs #39, #40, #41, #42. Add authenticated configuration sync, safe shared-button recovery, app settings and verified local/QEMU coverage.
2026-11-04 feat(mobile): pair devices with verified ownership and bounded retries
2026-11-04 fix: retain local wiring through pairing and calibration
2026-11-06 Add compact device mode projection endpoint (GET /device/mode-settings)
    The firmware's bounded HTTP buffer cannot read the large /settings body, so
    expose only contract_version, paired and mode. Unpaired devices get mode null.
2026-11-06 Document mode-settings in the device function header
2026-11-06 Extract the device HTTP client from pusher_sync
    Move the bounded authenticated request and retry backoff into device_http so
    the mode/heartbeat sync can share them. No pusher behaviour change.
2026-11-06 Follow the household mode from the app and send heartbeats
    Fetch GET /device/mode-settings every 15 s, keep the last good mode in NVS
    (build-time DOOR_RELAY_MODE only before the first fetch), and drop chimes and
    manual call requests in stop mode before a call starts. Unknown or malformed
    responses never change the mode. PUT /device/heartbeat every 60 s with bounded
    backoff. voice_transport sends the runtime mode instead of the constant.
2026-11-06 Test the stop-mode visit payload against the device handler and the visits table
2026-11-06 Add devices.applied_mode and device_report_mode, and a PUT /device/mode-status route
    devices.mode stays the cloud-saved value. applied_mode / applied_mode_at hold what
    the device reports it is actually running; residents read them with the existing
    devices select, and only the service_role RPC can write them.
2026-11-06 Report the running mode to PUT /device/mode-status after a successful mode fetch
    The XIAO sends the mode it is actually running once after the first successful
    fetch of a boot and again whenever it differs from the last acknowledged report.
    A mode taken from NVS or the build-time default is never reported. Failures use
    the bounded backoff and never block the fetch, heartbeat or chime path.
2026-11-06 Expose applied mode, its report time and the last heartbeat on the Device model
    Adds toDevice so the repository maps the new devices columns (no UI yet).
2026-11-08 Enroll one chime with the XIAO mic and detect it on-device (#59)
    Add chime_detector with single-shot enrollment and on-device matching,
    wire it into audio_app/audio_core and the calibration UI, and add
    synthetic/WAV evaluation tools and tests.
2026-11-09 Add the chime enrollment cloud contract (#61)
    device_chime_enrollment holds the app's desired side (request_seq, action) and
    the device's reported side (handled_seq, phase, reason, registered) in separate
    write paths: request_chime_enrollment for residents, device_report_chime_enrollment
    for service_role only. Edge Function device gets GET chime-enrollment and
    PUT chime-enrollment-status with strict parsing. Adds pgTAP, Deno handler tests
    and a local HTTP integration script, and updates supabase/README.md and
    docs/spec.md (FR-9 pairing is in-app; chime registration is one ring).
2026-11-09 Receive chime-enrollment requests from the cloud and report progress (#62)
    The network task polls GET chime-enrollment, runs start/cancel through the
    audio_app enrollment API, and PUTs every phase change. Host tests use a fake
    HTTP and a fake audio task; ESP32 build and hardware are not verified.
2026-11-09 Add the chime enrollment domain rules, repository and mapper (#63)
    Pure view-state reducer for the app side of chime enrollment: a phase counts
    only when handled_seq equals request_seq, with pickup, listen and stall
    timeouts, the failure messages, heartbeat freshness and the onboarding gate.
2026-11-09 Add the device gate, the shared pairing hook and the chime enrollment hook (#63)
    The gate keeps device presence per household, decides once per launch whether
    to show the onboarding (no device and not skipped; a read failure never does),
    and remembers 'later' per household in AsyncStorage until a device is claimed.
2026-11-09 Add the onboarding screens and the settings entry for chime enrollment (#63)
    Guide, code entry and a shared chime flow (waiting, quiet, ring, check, done,
    failed) following the Claude Design boards; a new protected group in the root
    layout; the settings device card gets a re-register chime row.
2026-11-14 Move accounts and shop data to Supabase and remove demo code
    The voice backend now handles conversation only. Accounts, homes and
    shops, reservations, the Google Calendar connection and visit history
    live in Supabase; the backend reads them through the Edge Function
    "device" with the device key and holds no database or OAuth flow.
    - Remove the PostgreSQL account API, the SQLite reception store and both
    backend Google OAuth integrations.
    - Read the shop profile and today's reservations from Supabase, and
    record arrivals there. A device whose household has a shop gets the
    reception agent; homes and unpaired devices get the door agent.
    - Remove the demo mode, scripted/manual relay sessio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
2026-11-14 Point the XIAO relay e2e test at monban_backend
    The host e2e test imported door_backend, which this branch renames to
    monban_backend. Patch fetch_device_settings instead of
    fetch_house_settings, accept DeviceAgent's keyword arguments, and watch
    monban_backend in the workflow paths.
2026-11-14 Add one-shot J2 bench probe and extended pulse profile (#72)
2026-11-14 fix(voice): honor contextual departures and completed deliveries
    Return the canonical farewell for explicit departures and completed parcel drop-offs, while keeping acknowledgements, quoted or negated completions, and follow-up requests open. Preserve main presence-response behavior when porting the production-based candidate.
    Validation: backend pytest, 293 passed and 1 skipped; no live model or device calls.
    Refs #72
2026-11-14 Web版から予約先（Google カレンダー、Square）に接続できるようにする
    サーバーは OAuth の戻り先に tka2601:// しか許しておらず、Web 版の
    「Google でログイン」は 400（return_url が正しくありません）で失敗していた。
    - reservations 関数: 戻り先に、開発用の http://localhost と、シークレット
    APP_WEB_ORIGINS で許した https のオリジンを認める（return_url.ts）
    - Web 版: ポップアップではなく同じタブで同意画面へ移り、戻ってきた URL の
    google=pending&code=... で接続を完了し、問い合わせのない URL に置き換える
    - 試験: 戻り先の許可と拒否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
2026-11-14 Add a one-shot J3 bench probe beside the J2 probe (#72)
    External 5 V and the Mac cannot be connected together, and the servos do
    not move on Mac power alone, so J3 has to be checked the same way as J2:
    arm over USB, unplug, and let the next boot press once.
    `@j3-probe arm` stores the target before the stage, so an armed stage never
    pairs with a half-written target. A reservation made by the J2-only
    firmware has no target key and still means J2. An unknown target is
    skipped instead of being mapped to some servo.
2026-11-14 Keep "I'll come back later" ending the call (#72)
    The contextual closure change stopped three replies from ending the call
    that main still ends: 「あとでまた来ます」, 「あとで伺います」 and
    「失礼します。また来ます」.
    - `_FOLLOW_UP` took 「あとで…」 as 「あと、…」 introducing another
    request. 「あとで」 is a time, so it no longer counts as a follow-up.
    - A promise to come back was only accepted as the whole utterance. It is
    now also accepted as the final clause, like the other departures.
    「あと、サインをお願いします」 and other later requests or questions
    still keep the call open.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
2026-11-14 Web 版の本番への出し方と、予約先の接続に要る設定を README に書く
    monban-web は GitHub からの自動デプロイがつながっていない。main の更新後に
    誰がどう出すかと、APP_WEB_ORIGINS にオリジンを足す必要があることを残す。
    Refs #35, #33
2026-11-14 Port the API server, Supabase device API, relay v2 and chat history to Rust
    - #76: settings and production checks, auth, request window, capacity
    limiter, TrustedHost, CORS, body limit, /api/status, /api/connect,
    /api/tts-check, legal pages and the exported OpenAPI docs
    - #78: device API client, visit history PUT, reservation cache and
    ReceptionDesk
    - #80: /api/relay start validation and the v2 device-controlled turn
    protocol behind VoiceRuntime/OutputSink traits
    - #79: ChatContext with the livekit OpenAI message format, plus the
    Python oracle capture (tools/voice_oracle) and its fixtures
2026-11-14 fix(voice): keep "come back later" turns as departures
    The contextual-closure candidate stopped closing on turns that main closed:
    "あとでまた来ます", "あとで伺います", "失礼します。また来ます" and
    "じゃあまた来ますね". _FOLLOW_UP read "あとで" (later) as "あと" (another
    request), and _DEPARTURE_TURN had no place for a promise to return or a
    trailing ね/よ. Treat a promise to return as a departure phrase that may
    follow a goodbye, and only treat "あと" as a follow-up when it is not
    "あとで" ("あとですね" still is).
    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
2026-11-14 終話判定まわりのコメントを日本語にする
    PR #84 で追加したコードのコメントと docstring（保坂さんの候補コミットの分を含む）を日本語に書き直す。動作は変えない。
    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
2026-11-14 Port the v2 voice pipeline to Rust (#79)
    - ASR, streaming LLM with tool calls, speech.cpp TTS, markdown/emoji
    filters, tail trimming, resampling and warm-up clients
    - DoorAgent and ReceptionAgent with their tools, the tool-step loop
    and StreamAdapter-style 20-character TTS tokens with livekit's
    10 ms segment markers
    - DeviceRuntime registered as the relay v2 runtime factory
    - The turn hook runs before every reply, model tool calls receive
    their arguments and end_call is decided from the reply being sent
    All eight Python oracle scenarios match request for request,
    including the device PCM sha256.
2026-11-14 Add monban-relay-probe, a stand-in device for end-to-end checks (#82)
    It synthesizes the visitor's words with the configured TTS and runs one
    relay v2 call against the local API, printing transcripts and timings.
2026-11-14 Compare noise handling for XIAO relay turns on one synthetic corpus (#72)
    Add scripts that build a synthetic 16 kHz corpus, rebuild the XIAO noise
    candidate (d93de3b) and RMS endpointing for the host, apply Silero VAD and
    DeepFilterNet3, and transcribe with kotoba-whisper-v2.1 as asr.py does.
    Record the results and a recommendation in docs/verification.
    All audio is synthetic; no real XIAO recording was used.
2026-11-14 Let monban-relay-probe connect as the Cloudflare tunnel does (#82)
2026-11-14 設定画面の「反映待ち」の間だけ、本体の適用を取り直す（#72）
    モードを変えると、本体が適用を報告しても、設定画面は開き直すまで
    「反映待ち」のままだった。本体は15秒ごとにモードを取りに来て、
    適用したらすぐ報告するので、反映待ちの間だけ本体情報を取り直す。
    - 最初の1分は5秒ごと、その後は15秒ごと。20回（約3分）で止める
    - 保存中は取り直さない。取り直しの途中でモードを変えたら、古い結果は捨てる
    - 画面を離れたら止める。開き直せばまた始める
2026-11-14 TLS接続に失敗したとき、mbedTLSのエラーと空きメモリをログに出す（#72）
    11/14、XIAOからSupabaseの端末設定の取得が`status=0`で失敗した。
    CAは正しく、原因がTLSの拒否なのか、TLSの1本分のメモリが足りないのかを
    ログから区別できなかった。接続に失敗したら、接続先、mbedTLSのエラー、
    空きヒープ、内部RAMの最大の連続領域をUSBシリアルに出す。
2026-11-14 Port livekit's Silero VAD to Rust as monban-vad (#81)
    Add crates/monban-vad: the Silero v5 model (from livekit-plugins-silero 1.8.8,
    MIT) run through ort / ONNX Runtime 1.31, and a port of livekit's
    VADStream._main_task for 16 kHz input (exp filter alpha 0.35, activation and
    deactivation thresholds, min speech/silence accumulation, prefix padding,
    max_buffered_speech, flush as a hard reset). The API is synchronous:
    Vad::new(options), vad.stream(), stream.push(&[i16]), stream.flush().
    tools/vad_oracle/capture.py records livekit's events and per-window
    probabilities on 12 synthesized scenarios (say voices, noise, gaps, flush,
    max buffer); the Rust tests match every event, time, speech audio h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
2026-11-14 来客対応の待ち時間を測るため、XIAOに[TIMING]の記録と集計スクリプトを足す（#72）
    Issue #72の完了条件「チャイムから挨拶まで」「来客が話し終えてから返答が聞こえるまで」を
    実機のログから測れるようにする。
    - timing.h：1行1イベントで、XIAOのms時計とNTPの時刻（epoch_ms、未設定なら0）を出す。
    epoch_msはサーバーのログとの照合に使う。
    - 記録点：call_start、call_press_requested、relay_ready、listen_start、speech_end、
    reply_start、playback_start（スピーカーが実際に鳴り始めた時刻）、playback_done、
    end_press_requested、call_end
    - playback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
2026-11-14 Run the XIAO host e2e against the Rust relay (#80)
    bash firmware/xiao/run.sh e2e-rust builds examples/e2e_server.rs (the
    real Rust router and relay with the e2e Agent) and runs the same five
    tests as the Python e2e.
2026-11-14 試験用のPreferencesにcstdintを足し、LinuxのCIでもuint8_tが通るようにする（#72）
2026-11-14 Trace voice stages and add a loopback relay latency experiment
    Measure settings and ready, generation receipt and scheduling, recognition, tokenization, TTS headers/PCM/completion, resampling and the first relay write without logging text, audio or credentials.
    Keep the slow upstream experiment opt-in and local; simulated latency does not identify the production delay. Refs #72
2026-11-14 Stream TTS PCM into the device relay before sentence completion
2026-11-14 Share the synthetic delivery fixture and a correlated relay v2 latency probe
2026-11-14 Wake the on-demand models when a call starts (#82)
    Modal stops ASR, the LLM and TTS 60 s after their last request, and the
    Rust API never called the warm-up, so a call after a minute of quiet met
    cold models only when the visitor's words arrived (ASR 408 and a retry,
    14 s to the reply, in production). Start a background warm-up at call
    start; one runs at a time and a success within 30 s covers the next call.
    Also use is_multiple_of for the PCM sample check (clippy).
2026-11-14 Let 16 unacknowledged output frames fly so replies outrun playback (#82)
    Through the public Cloudflare path (~240 ms round trip) a window of 10
    frames delivered 200 ms of audio per round trip: a 3.7 s reply took
    4.6 s to arrive and the 32-frame prebuffer filled 0.7 s after the first
    frame. The XIAO queues 64 frames and credits 48 before they play, so 16
    always fits; it delivers 320 ms per round trip.
